teknoroman/BotKar-UPA/README.md

# BotKar-UPA
### Hezkuntza mailan erabiltzeko robota.

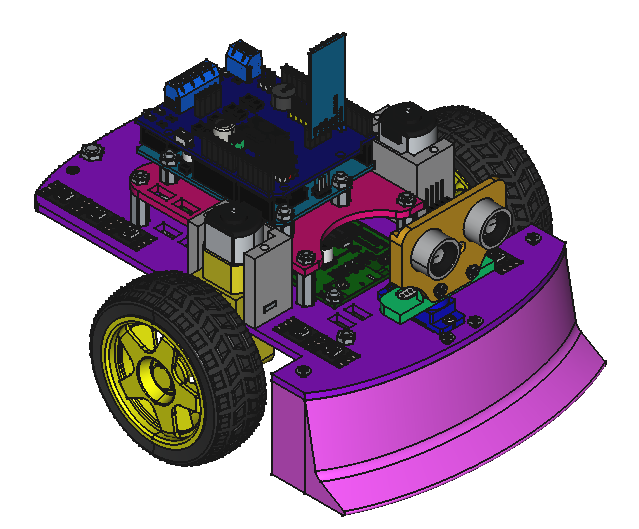
[picture p1: BotKarUPA.png]
