teknoroman/BotKar-UPA/AURKEZPENAK/6.1.- PROGRAMAZIO INGURUNEA_ HELLO BLOCKS (24-25).pptx

## PROGRAMAZIO INGURUNEA HELLO BLOCKS

KONTROLA - AUTOMATIZAZIOA - PROGRAMAZIOA

2024 - 2025 IKASTURTEA
IES USANDIZAGA-PEÑAFLORIDA-AMARA BHI

## HELLO BLOCKS

- ZER DA? UNO MIKROKONTROLAGAILUA ONLINE ETA BLOKEEN BIDEZ PROGRAMATZEKO INGURUNEA
- WEB GUNEA: https://hello-blocks.com/
- ALDE: ONLINE; BLOKEETAN PROGRAMATU; EZ DA EZER INSTALATU BEHAR; EUSKARAZ.

## HELLO BLOCKS PROGRAMATZEKO PAUSUAK

1.

2.

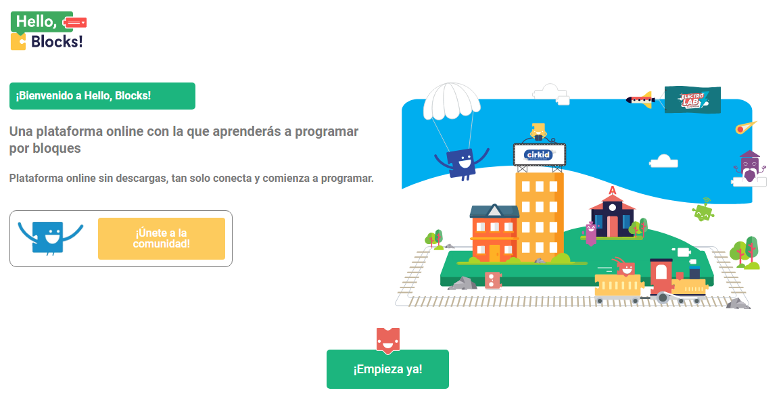
[picture p2: figure]
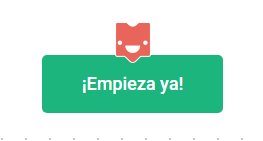
[picture p3: figure]
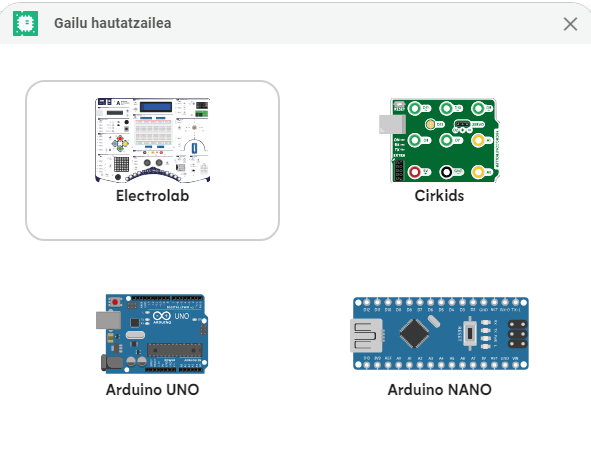
[picture p4: figure]

3.

## 2.- HELLO BLOCKS PROGRAMAZIO INGURUNEA

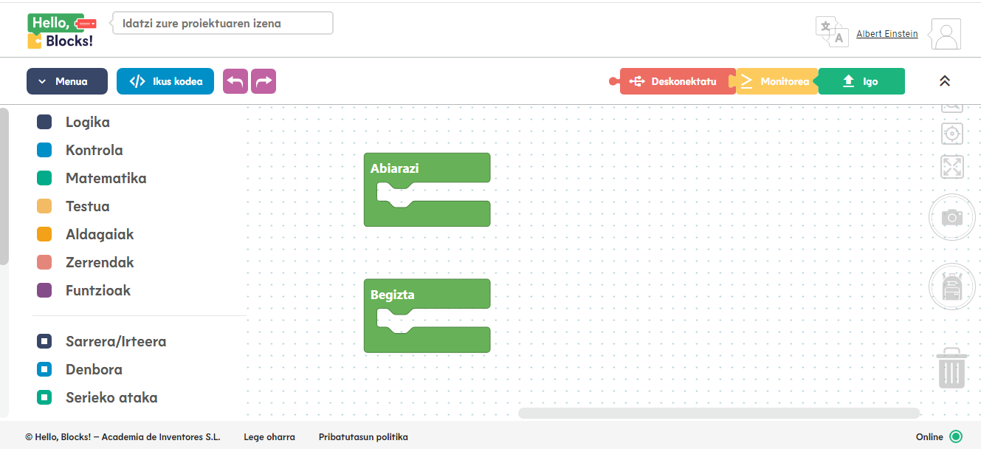
[picture p5: figure]

## Slide 5

TEKNOROMAN

IES USANDIZAGA-PEÑAFLORIDA-AMARA BHI

ARDUINO UNO PROGRAMATZEA

Fluxu diagrama (1.prog.)

Ordenagiluan programa idatzi aurretik, pinen esleipena egin behar da zeintzuk izango diren sarrerak eta zeintzuk irteerak ezarriz eta pin bakoitzean zein osagai egongo den konektatua adieraziz. Ondoren fluxu diagrama baten bitartez programaren nondik norakoa marrazten da.

INDUSTRIA TEKNOLOGIA

hasiera

aginduak

baldintzak

bai

ez

http://teknologiaroman.blogspot.com.es/

Hasiera
Aldagaien deklarazioa eta setup

LED
piztu

ITXOIN 5s.

LED
itzali

ITXOIN 5s.

“KAIXO MUNDUA” programarako adibidea

ARDUINO

## Slide 6

TEKNOROMAN

IES USANDIZAGA-PEÑAFLORIDA-AMARA BHI

ARDUINO UNO PROGRAMATZEN

pinen esleipena (1. prog.)

Ordenagiluan programa idatzi aurretik, pinen esleipena egin behar da zeintzuk izango diren sarrerak eta zeintzuk irteerak ezarriz eta pin bakoitzean zein osagai egongo den konektatua adieraziz. Ondoren fluxu diagrama baten bitartez programaren nondik norakoa marrazten da.

INDUSTRIA TEKNOLOGIA

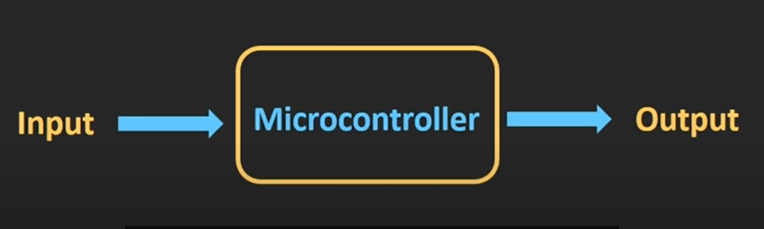
[picture p6: figure]

PINEN ESLEIPEN TAULA

SENTSORE/ERAGINGAILU | MOTA | ALDAGAIA | PINA
LED | IRTEERA DIGITALA | LED | 2

http://teknologiaroman.blogspot.com.es/

“KAIXO MUNDUA” programarako adibidea

ARDUINO
