teknoroman/BotKar-UPA/AURKEZPENAK/BotKarUPA-GANTT DIAGRAMA (2024-2025).docx

BotKarUPA (2024-2025) EPEAK - GANTT DIAGRAMA

| Mar27 | Api1 | Api3 | Api8 | Api10 | api29 | Mai6 | Mai8 | Mai13 | EKAINAK 2-5 | EKAINAK 6
MUNTAIA
PROIEKTU HASIERA - AURKEZPENA
ROBOT MUNTAIA: MATERIAL BANAKETA - IDENTIFIKAZIOA
ROBOT MUNTAIA: TXASISA+MOTORRAK+ELIKATZEA
ROBOT MUNTAIA: KONTROLA+DRIVER-a
ROBOT MUNTAIA: INFRAGORRI SENTSOREAK
ROBOT MUNTAIA: ULTRASOINU SENTSOREA + SERBOA
PROGRAMAZIOA
TESTAK: SOINUA+MOTORRA+ARGIAK
TESTAK: ULTRASOINU+INFRAGORRI
ROBOTA PROGRAMATU: ERRONKAK

LEHIAKETA
ROBOT LEHIAKETA: PRESTAKETA
ROBOT LEHIAKETA EGUNA
