teknoroman/BotKar-UPA/EBALUAZIOA/TKING-I5K KUADERNO DIGITALA (24-25) fitxategiaren kopia.docx

BotKarUPA ebaluaziorako txantiloia (24-25) 5K

Zb | IZEN ABIZENAK | BUKATUTA. | SOINUA | NEOPIXEL | MOTORRAK | DISTANTZIA | INFRAGORRIAK
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
Zb | IZEN ABIZENAK | BUKATUTA. | SOINUA | NEOPIXEL | MOTORRAK | DISTANTZIA | INFRAGORRIAK
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
TEKNOLOGIA MINTEGIA/DEPARTAMENTO DE TECNOLOGÍA
