teknoroman/BotKar-UPA/AURKEZPENAK/0.- AURKEZPENA - ROBOTIKA ETA PROGRAMAZIOA BotKar-UPA (24-25).pptx

## ROBOTIKA- PROGRAMAZIOA- KONTROLA BotKar-UPA AURKEZPENA

2024 - 2025 IKASTURTEA
IES USANDIZAGA-PEÑAFLORIDA-AMARA BHI

ZER DA ROBOTIKA https://zthiztegia.elhuyar.eus/terminoa/eu/robot ZER DA PROGRAMAZIOA https://zthiztegia.elhuyar.eus/terminoa/eu/programazio ZER DA KONTROLA https://zthiztegia.elhuyar.eus/terminoa/eu/kontrol AUTOMATIKA https://zthiztegia.elhuyar.eus/terminoa/eu/automatika AUTOMATISMOA https://zthiztegia.elhuyar.eus/terminoa/eu/automatismo

https://berezuma.com/batx2/kontrol-sistemak-motak/

## KONTROL SISTEMAREN OSAGAIAK

SISTEMA
PROZESUA

ZER KONTROLA DAITEKE ETA ZER EZ

ERANTZUNA, PORTAERA IKERTU

SARRERA ALDAGAIAK

SISTEMA
PROZESUA

IRTEERA ALDAGAIAK

PERTURBAZIOAK

## KONTROL MOTAK BEGIZTA IREKIA BEGIZTA ITXIA

SARRERA ALDAGAIAK

KONTROLAGAILUA

SISTEMA
PROZESUA

IRTEERA ALDAGAIAK

PERTURBAZIOAK

SARRERA ALDAGAIAK

KONTROLAGAILUA

SISTEMA
PROZESUA

IRTEERA ALDAGAIAK

PERTURBAZIOAK

BERRELIKADURA

## BotKarUPA

mClon

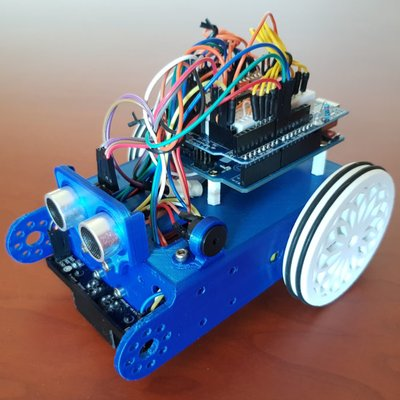
[picture p7: figure]

https://tecnoloxia.org/mclon/


mClon-UPA

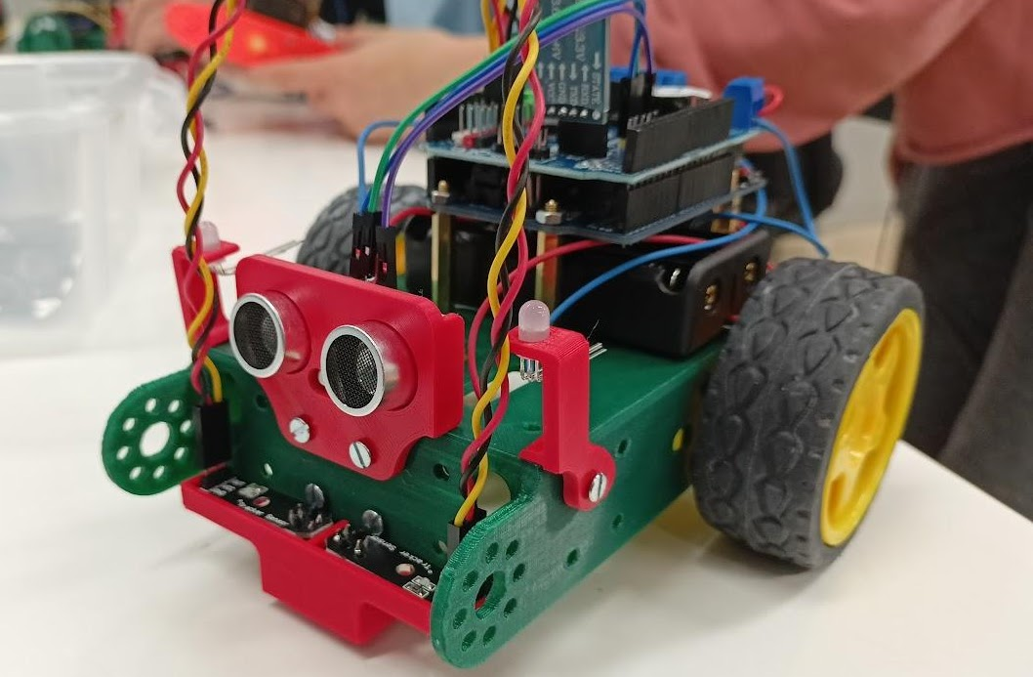
[picture p8: figure]

https://sites.google.com/upainstitutua.org/mclon-upa/sarrera

## HELBURUA

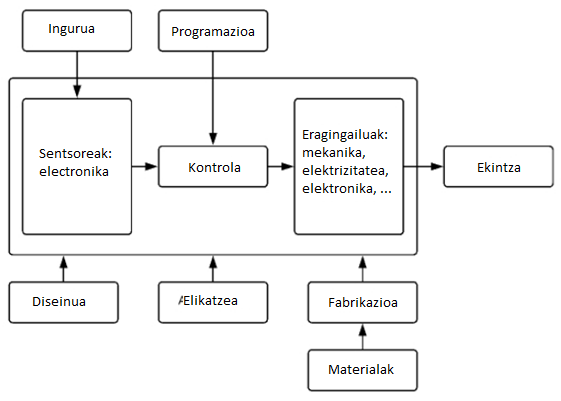
[picture p9: figure]

María Loureiro
@tecnoloxia (https://twitter.com/tecnoloxia?lang=en)

## MUNTAIA + TESTAK + LEHIAKETA

0.- MATERIALAREN IDENTIFIKAZIOA
1.- TXASISA ETA MOTORRAK
2.- ELIKATZE SISTEMA
3.- KONTROL PLACA: ARDUINO + FUNDUMOTO SHIELD
4.- SENTSOREAK: ULTRASOINUAK ETA INFRAGORRIAK

5.- ARGIAK: NEOPIXEL
6.- KOMUNIKAZIOA: BLUETOOTH

## ERRONKAK - LEHIAKETA

1.- PUNTU KARDINALAK
2.- ESKORTATIK IRTEN
3.- LERRO JARRAITZAILEA
4.- SUMO
4’.- SUMO
5.- LASTERKETA
6.- PUXIKA BORROKA

AUTONOMOA

GIDATUA

## ARGITARATZEA

1.- MUNTAIA-TESTAK-FROGAK
2.- BEHIN-BETIKO EMAITZAK
3.- IRUDIAK
4.- BIDEOAK
5.- KODEA
6.- AZALPENAK

SITES

HELBURUA

ERREPIKAKORRA

## DENBORALIZAZIOA-EPEAK-DATAK

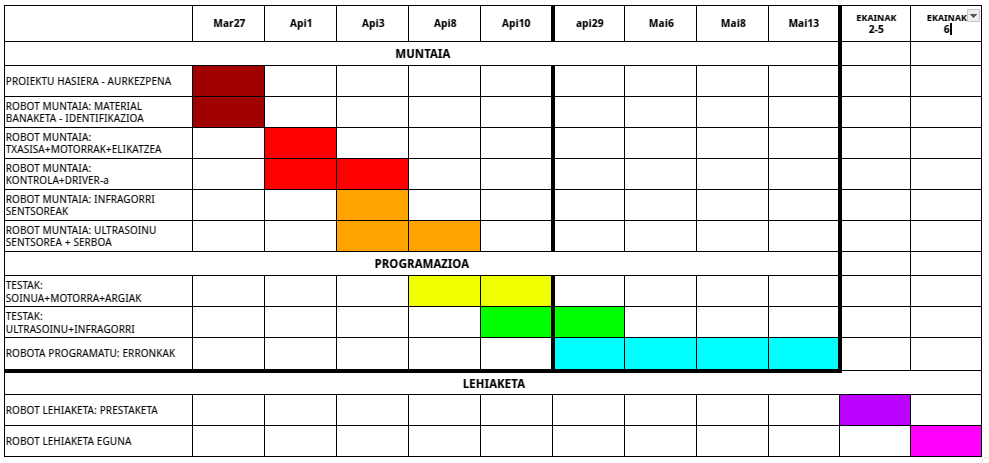
[picture p10: figure]
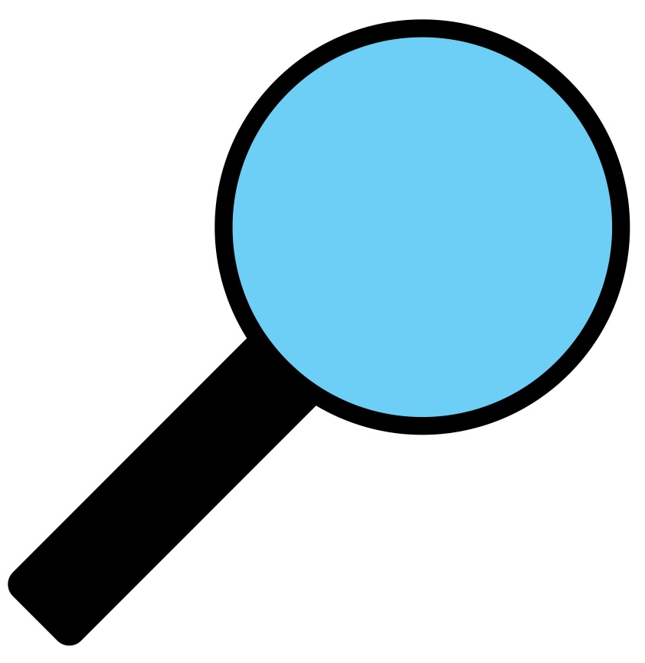
[picture p11: figure]
