teknoroman/BotKar-UPA/argazkiak-bideoak/Bideoak/IMG_20250317_153037.jpg

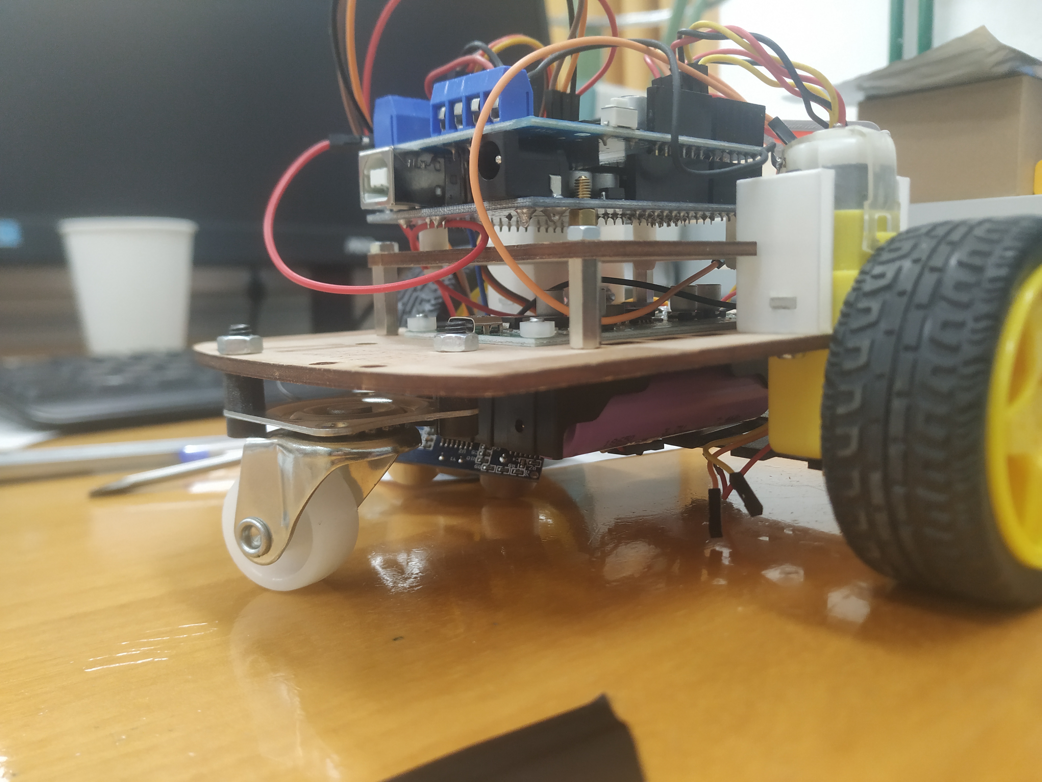
argazkiak-bideoak/Bideoak/IMG_20250317_153037.jpg
