teknoroman/BotKar-UPA/argazkiak-bideoak/Bideoak/IMG_20250404_192219.jpg

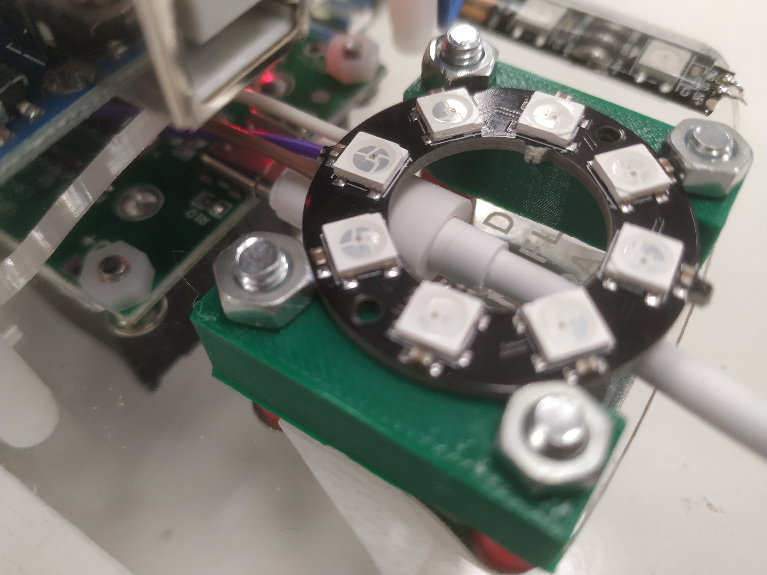
argazkiak-bideoak/Bideoak/IMG_20250404_192219.jpg
