teknoroman/BotKar-UPA/argazkiak-bideoak/Bideoak/IMG_20250404_192254.jpg

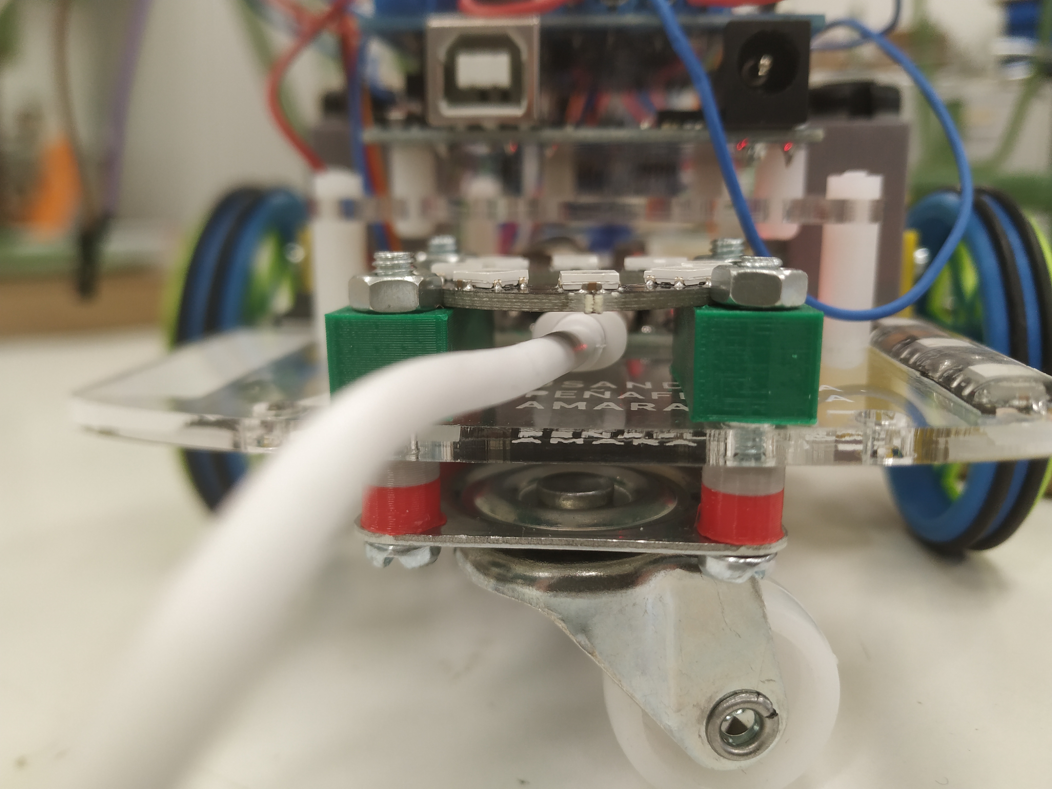
argazkiak-bideoak/Bideoak/IMG_20250404_192254.jpg
