teknoroman/BotKar-UPA/argazkiak-bideoak/Bideoak/IMG_20250407_084235.jpg

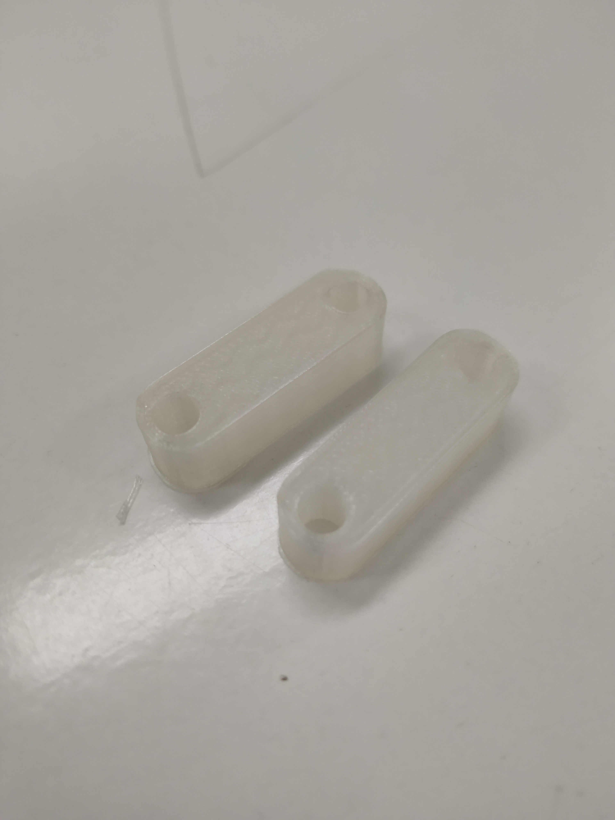
argazkiak-bideoak/Bideoak/IMG_20250407_084235.jpg
