teknoroman/BotKar-UPA/argazkiak-bideoak/Bideoak/IMG_20250407_084258.jpg

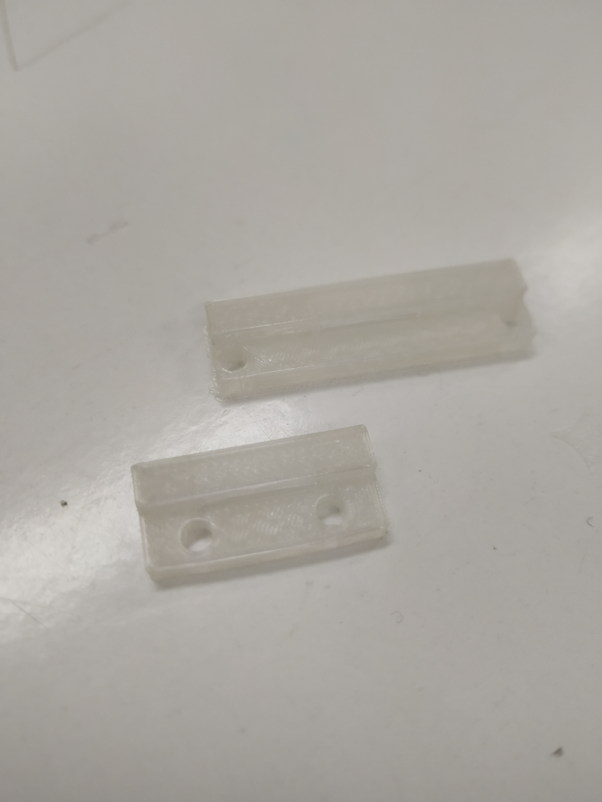
argazkiak-bideoak/Bideoak/IMG_20250407_084258.jpg
