teknoroman/BotKar-UPA/argazkiak-bideoak/Bideoak/IMG_20250407_095248.jpg

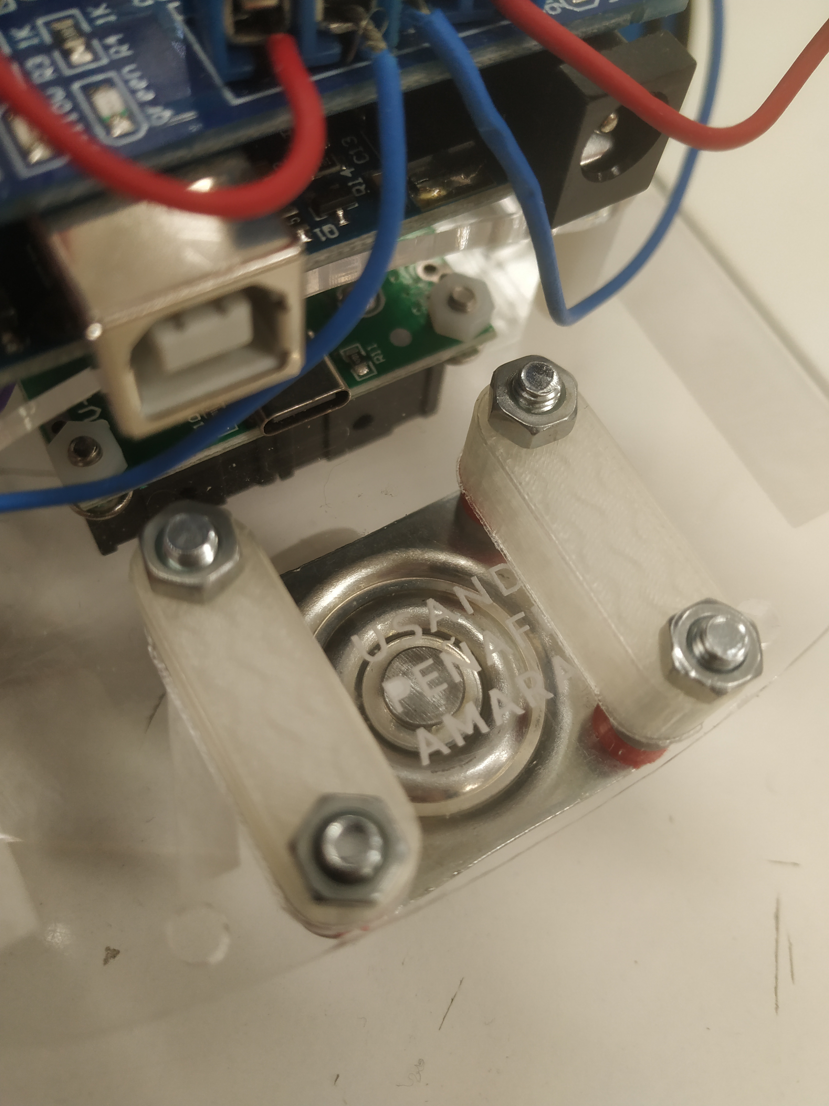
argazkiak-bideoak/Bideoak/IMG_20250407_095248.jpg
