teknoroman/BotKar-UPA/argazkiak-bideoak/Bideoak/IMG_20250407_095250.jpg

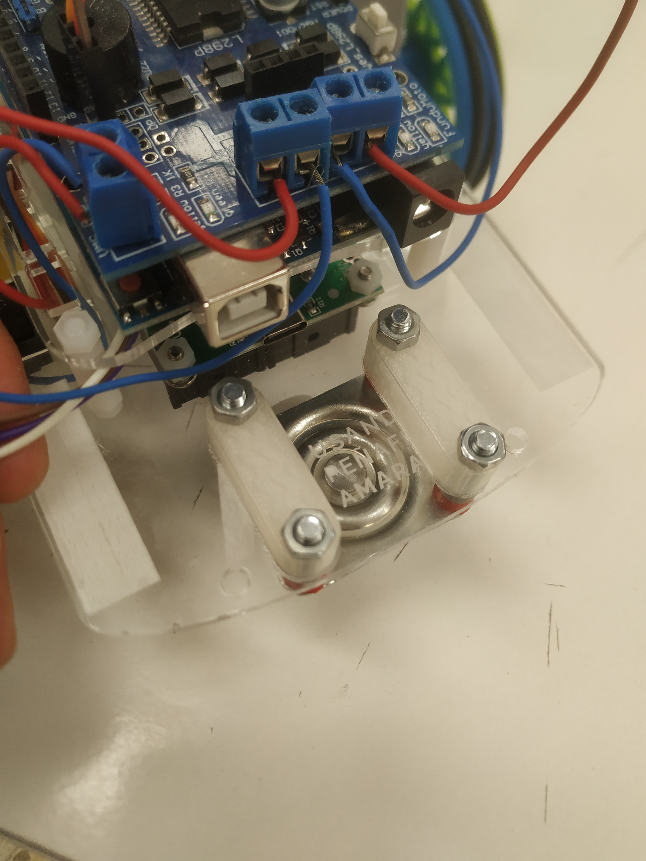
argazkiak-bideoak/Bideoak/IMG_20250407_095250.jpg
