teknoroman/BotKar-UPA/argazkiak-bideoak/Bideoak/IMG_20250407_095345.jpg

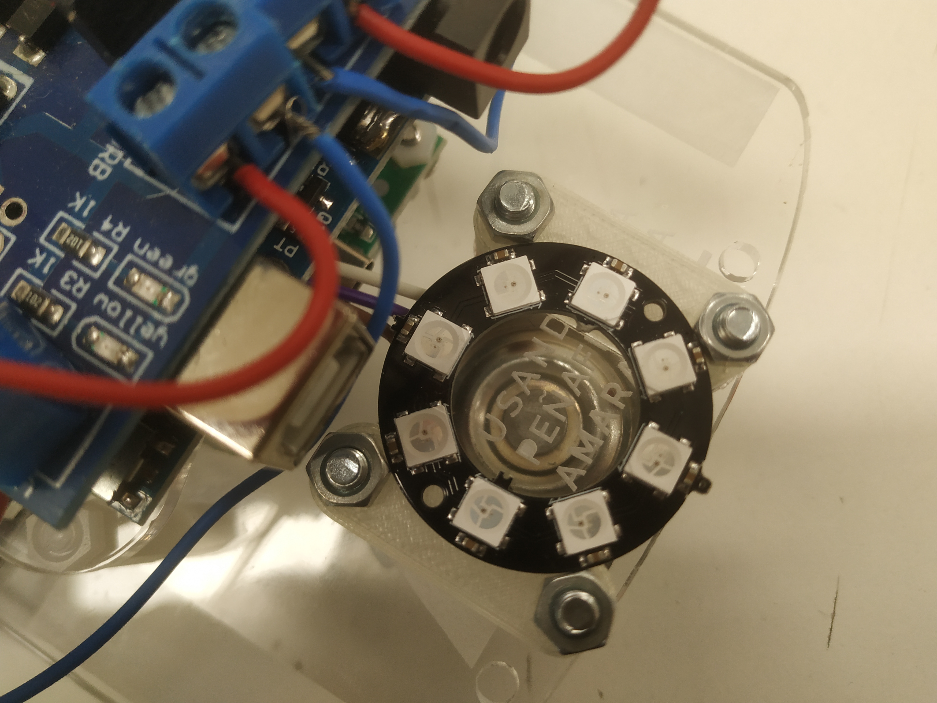
argazkiak-bideoak/Bideoak/IMG_20250407_095345.jpg
