teknoroman/BotKar-UPA/argazkiak-bideoak/Bideoak/IMG_20250407_100635.jpg

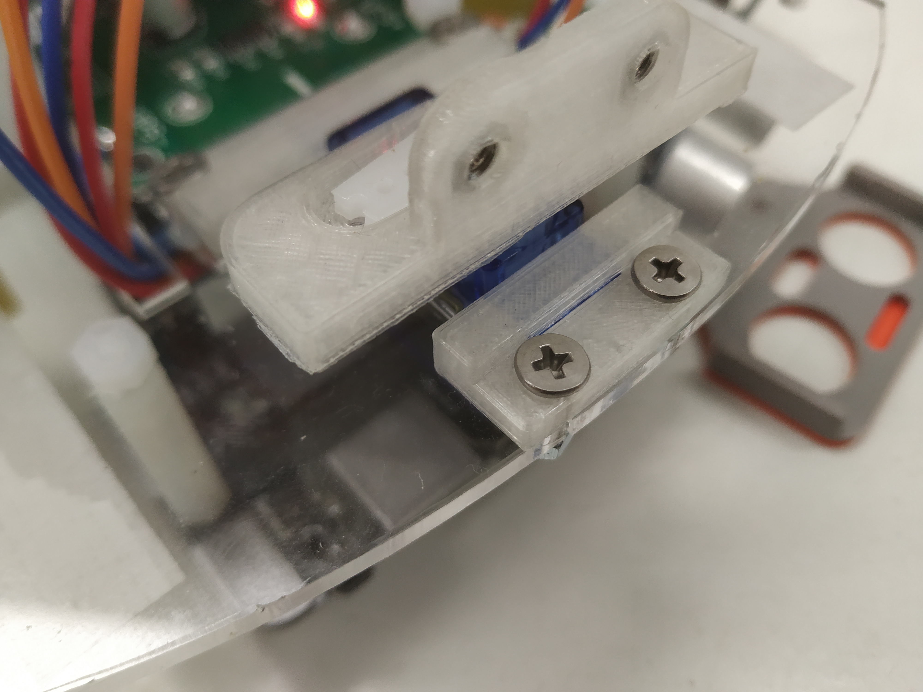
argazkiak-bideoak/Bideoak/IMG_20250407_100635.jpg
