teknoroman/BotKar-UPA/argazkiak-bideoak/Bideoak/IMG_20250407_100657.jpg

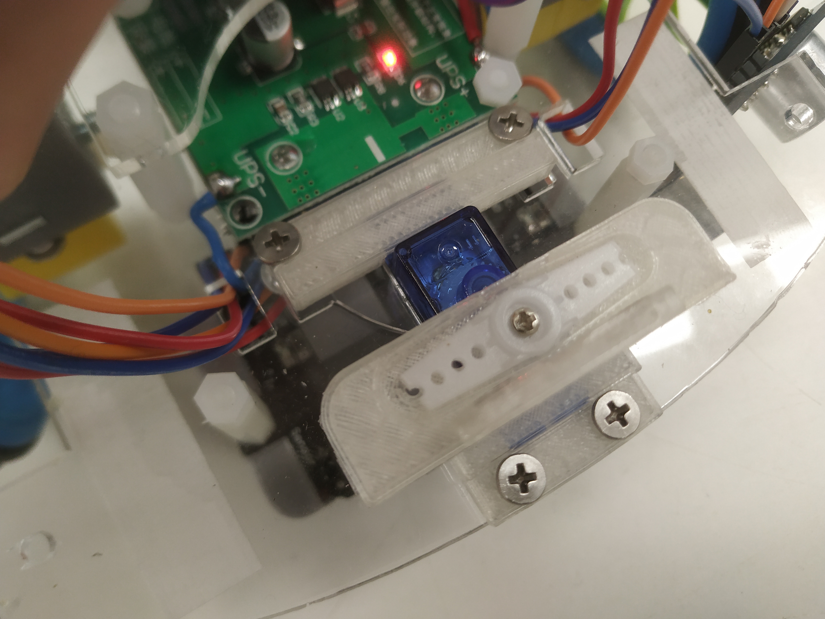
argazkiak-bideoak/Bideoak/IMG_20250407_100657.jpg
