teknoroman/BotKar-UPA/argazkiak-bideoak/Bideoak/IMG_20250407_102820.jpg

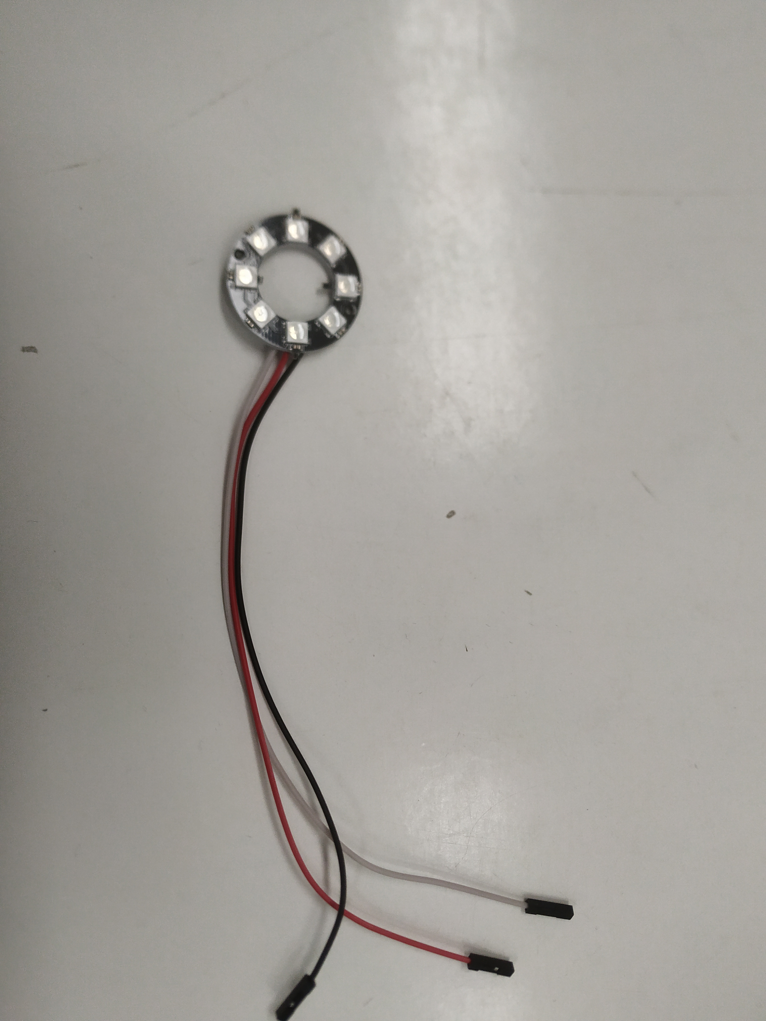
argazkiak-bideoak/Bideoak/IMG_20250407_102820.jpg
