teknoroman/BotKar-UPA/argazkiak-bideoak/Bideoak/IMG_20250407_102908.jpg

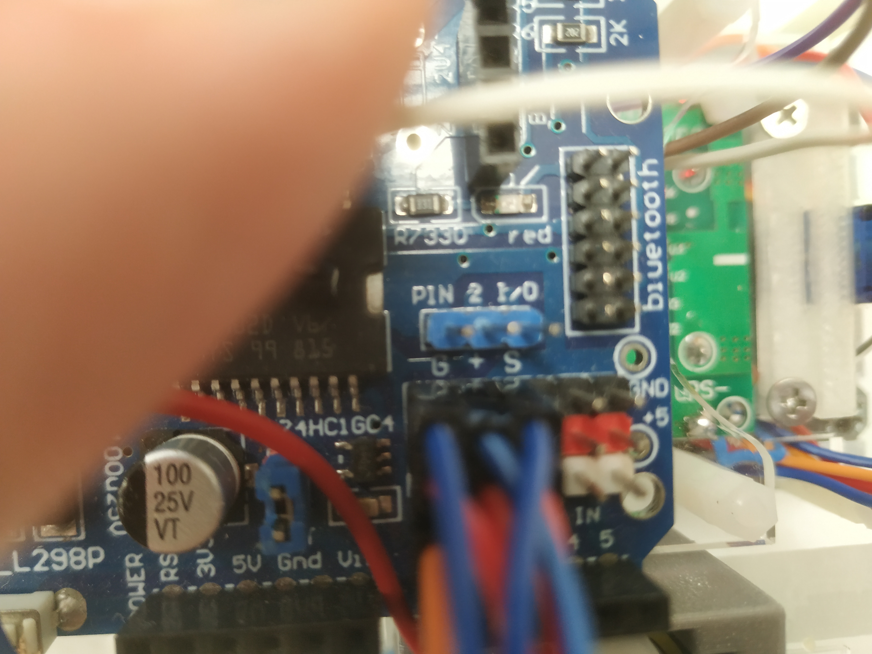
argazkiak-bideoak/Bideoak/IMG_20250407_102908.jpg
