teknoroman/BotKar-UPA/argazkiak-bideoak/Bideoak/IMG_20250428_235727.jpg

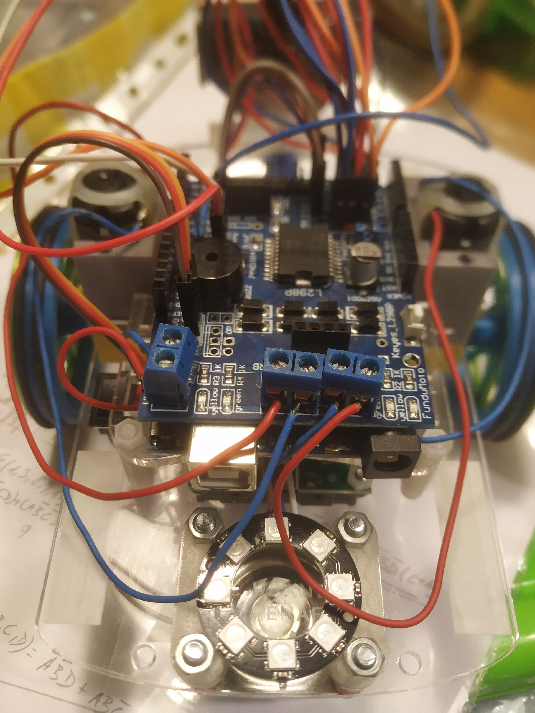
argazkiak-bideoak/Bideoak/IMG_20250428_235727.jpg
