teknoroman/BotKar-UPA/argazkiak-bideoak/Bideoak/IMG_20250428_235746.jpg

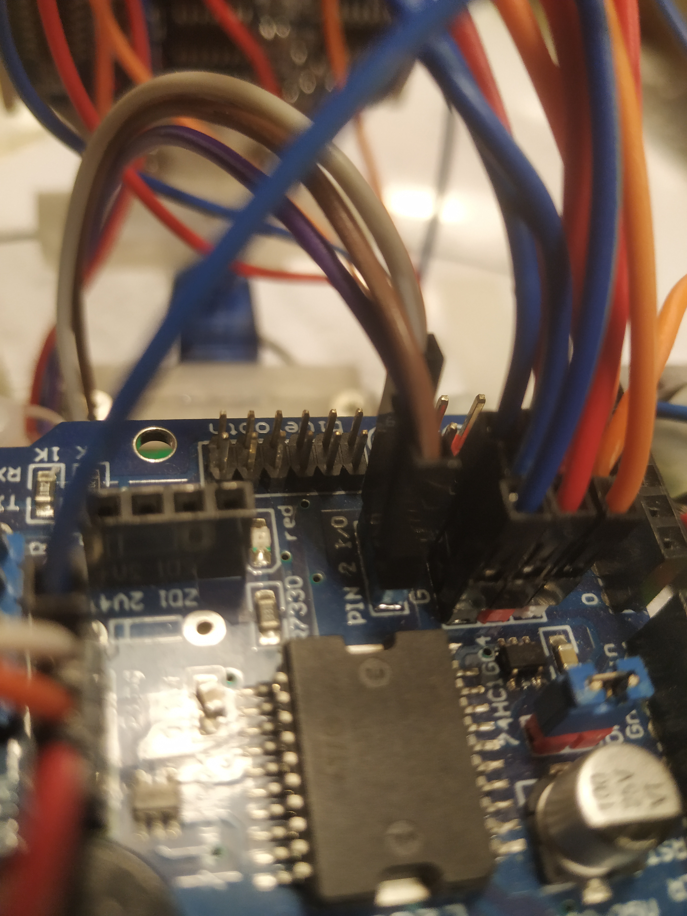
argazkiak-bideoak/Bideoak/IMG_20250428_235746.jpg
