teknoroman/BotKar-UPA/EBALUAZIOA/DISTANTZIA ETA INFRAGORRIAK.png

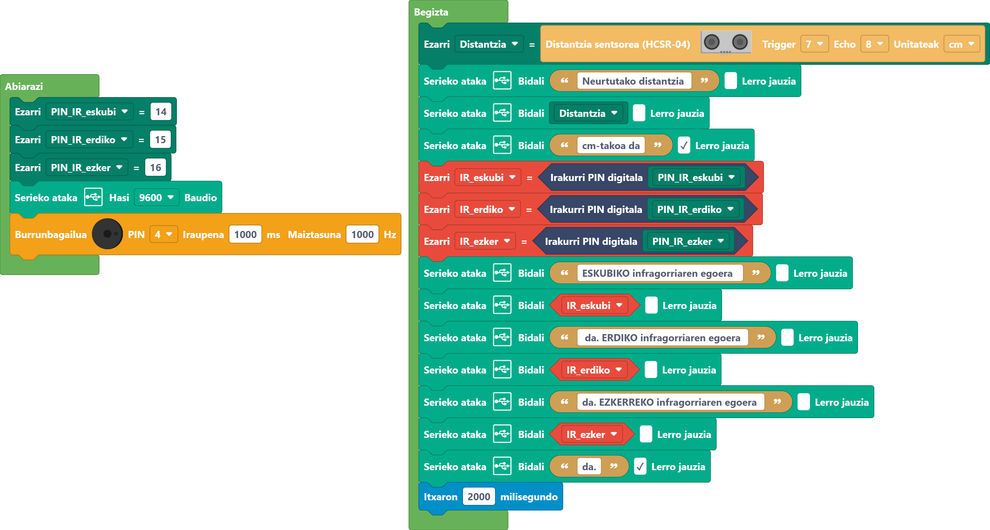
EBALUAZIOA/DISTANTZIA ETA INFRAGORRIAK.png
