teknoroman/BotKar-UPA/EBALUAZIOA/SOINUA-ARGIAK-MOTORRAK.png

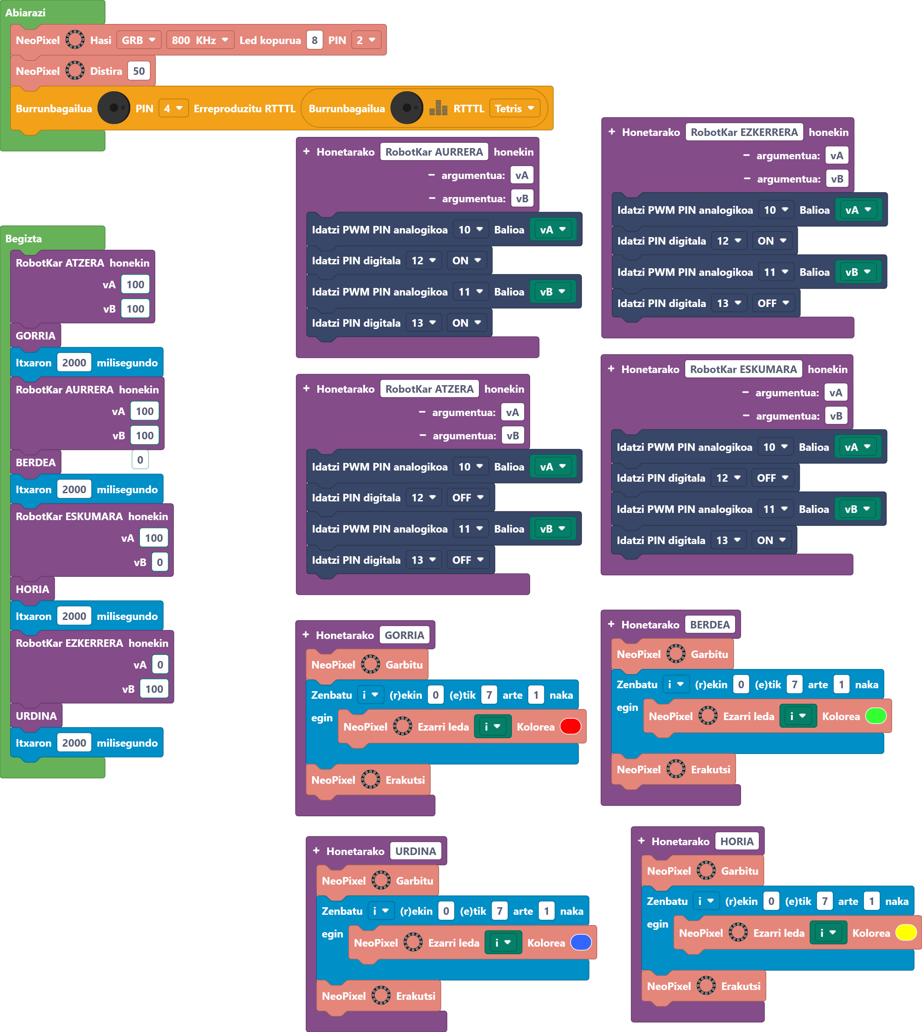
EBALUAZIOA/SOINUA-ARGIAK-MOTORRAK.png
