teknoroman/BotKar-UPA/PROGRAMAK/ARGI FROGAK.png

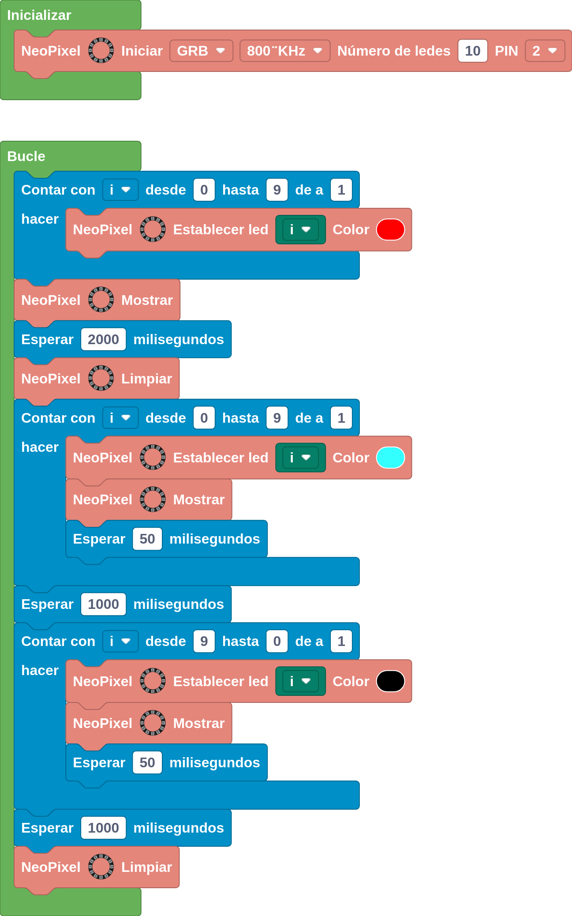
PROGRAMAK/ARGI FROGAK.png
