teknoroman/BotKar-UPA/PROGRAMAK/BLUETOOTH (KarBotUPA).png fitxategiaren kopia.png

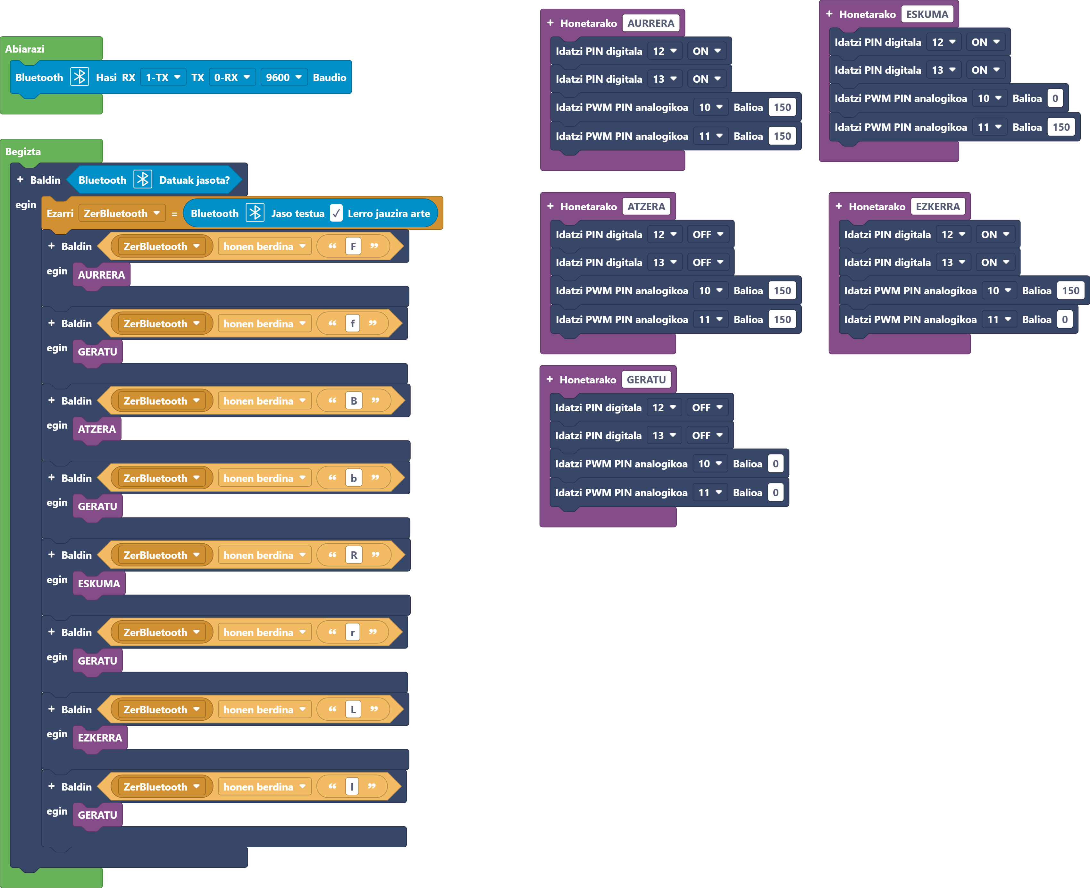
PROGRAMAK/BLUETOOTH (KarBotUPA).png fitxategiaren kopia.png
