teknoroman/BotKar-UPA/PROGRAMAK/BuruaBiratuz.png

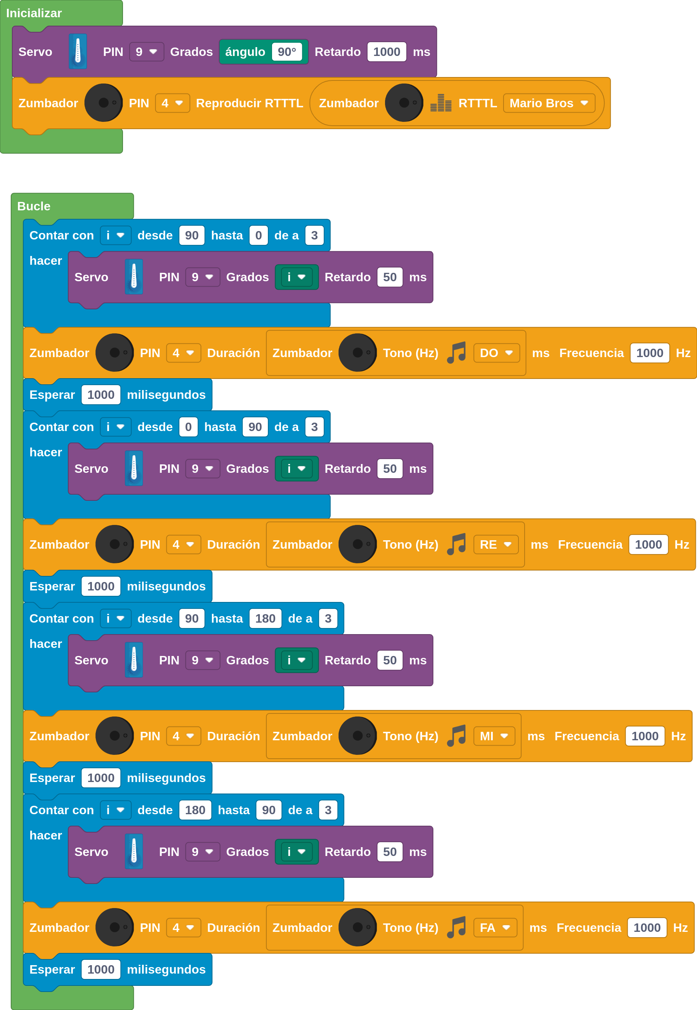
PROGRAMAK/BuruaBiratuz.png
