teknoroman/BotKar-UPA/PROGRAMAK/FROGA-BLUETOOTH-APPINVENTOR (1).png

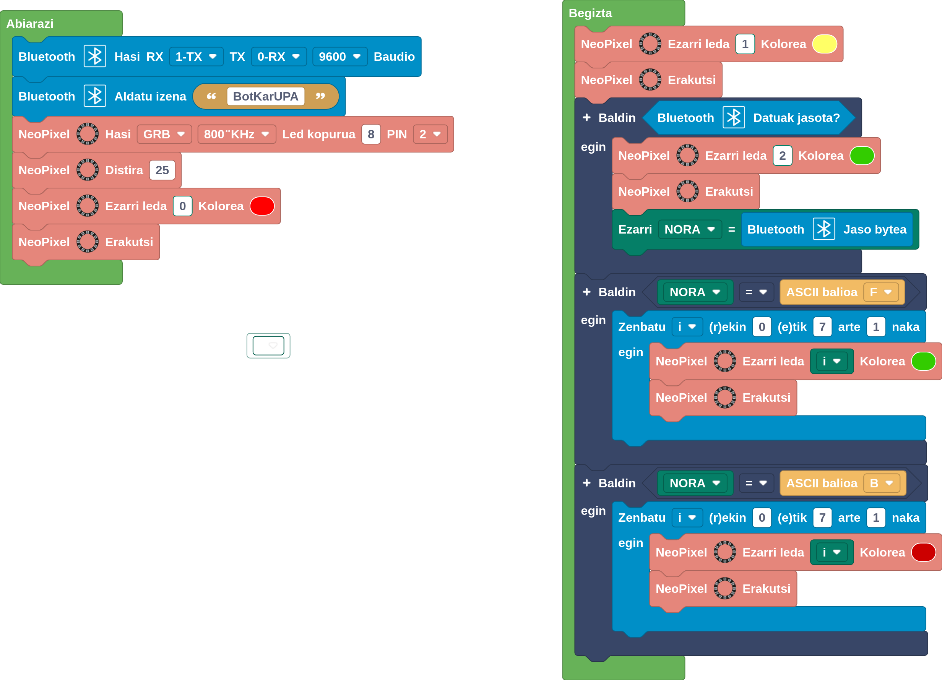
PROGRAMAK/FROGA-BLUETOOTH-APPINVENTOR (1).png
