teknoroman/BotKar-UPA/PROGRAMAK/MOTORRAK AURRERA ETA ATZERA.png

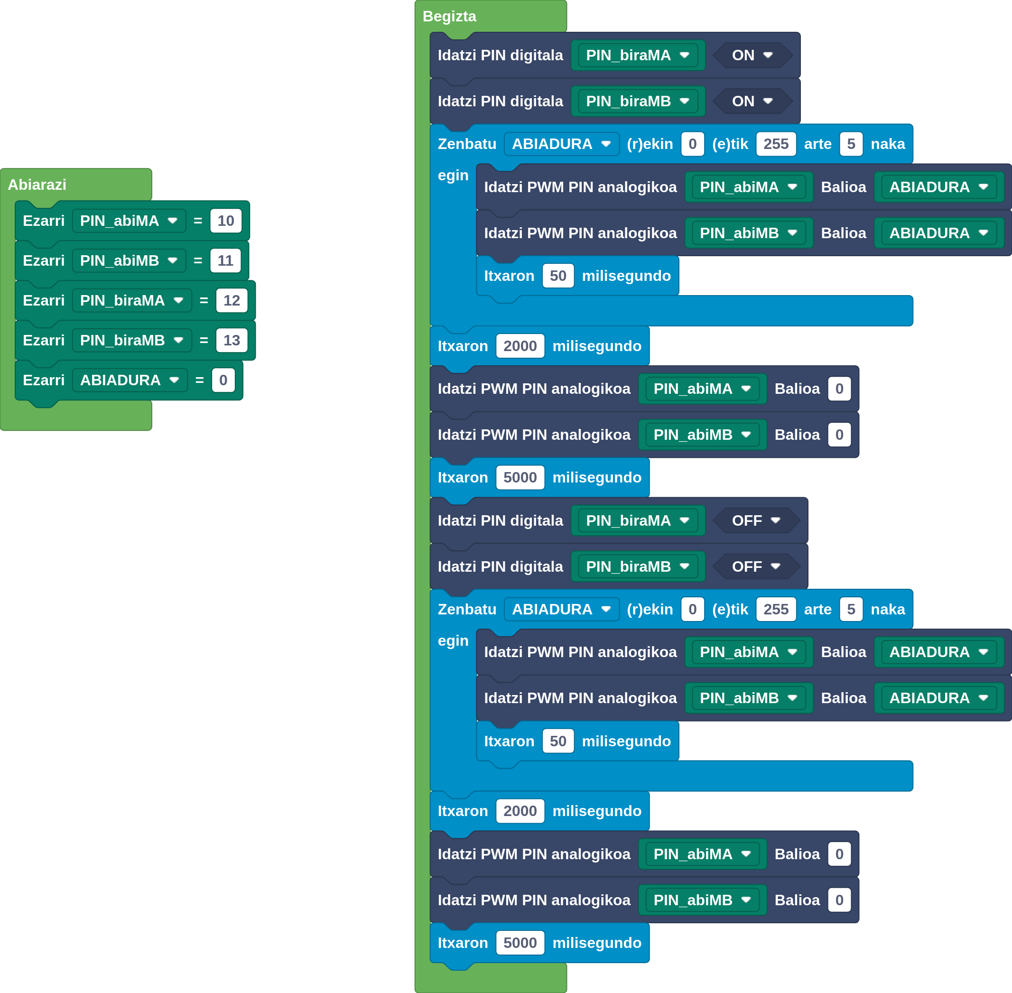
PROGRAMAK/MOTORRAK AURRERA ETA ATZERA.png
