teknoroman/BotKar-UPA/PROGRAMAK/motorrak-frogatzen 2.png

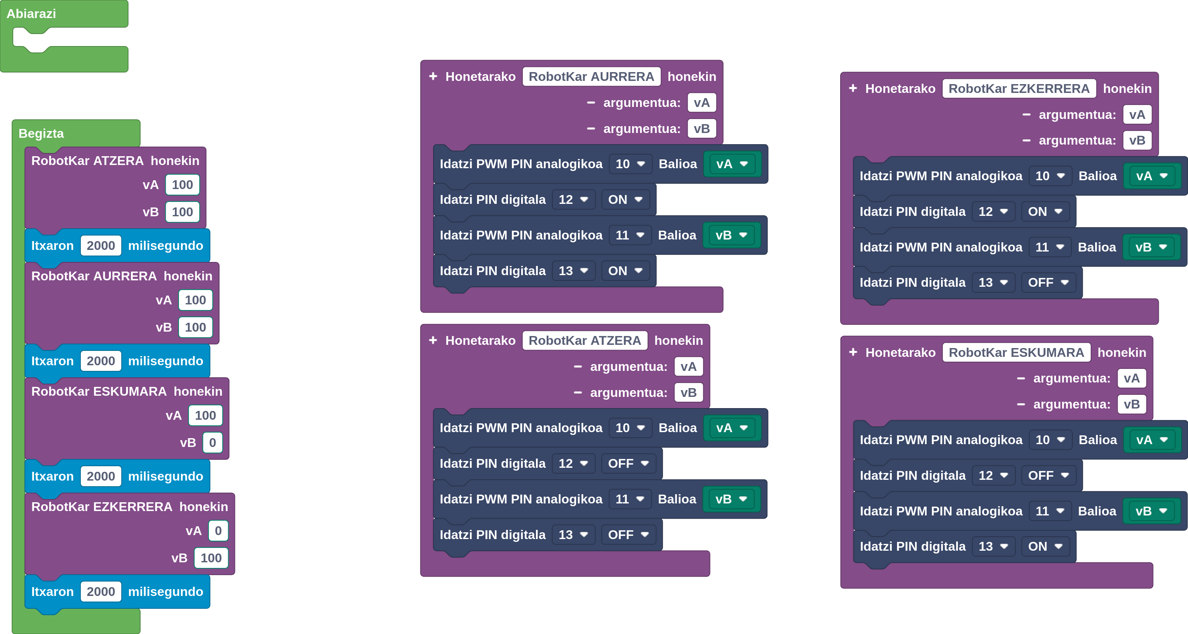
PROGRAMAK/motorrak-frogatzen 2.png
