teknoroman/BotKar-UPA/PROGRAMAK/motorrak-frogatzen.png

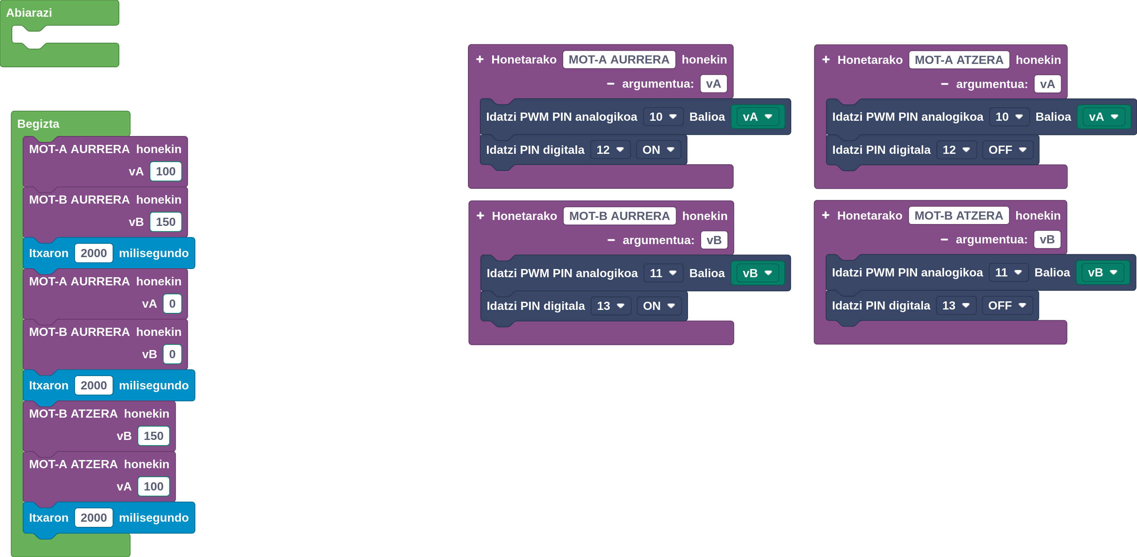
PROGRAMAK/motorrak-frogatzen.png
