teknoroman/BotKar-UPA/PROGRAMAK/Soinu Froga.png

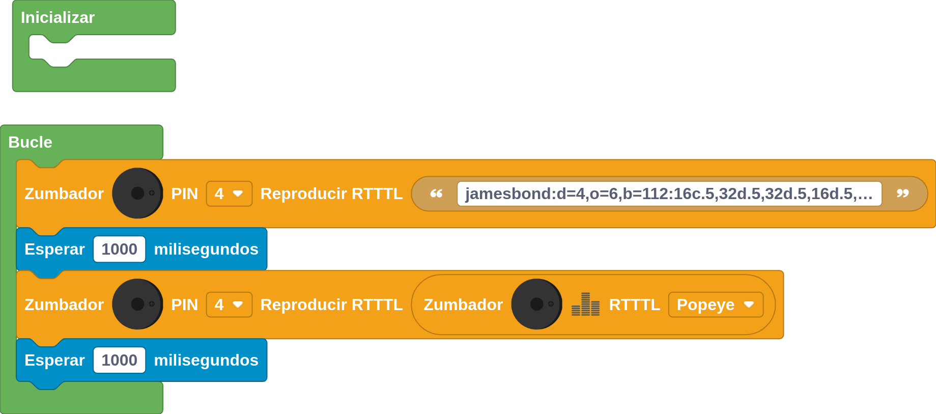
PROGRAMAK/Soinu Froga.png
