teknoroman/BotKar-UPA/PROGRAMAK/ULTRASOINU ETA MOTORRAK.png

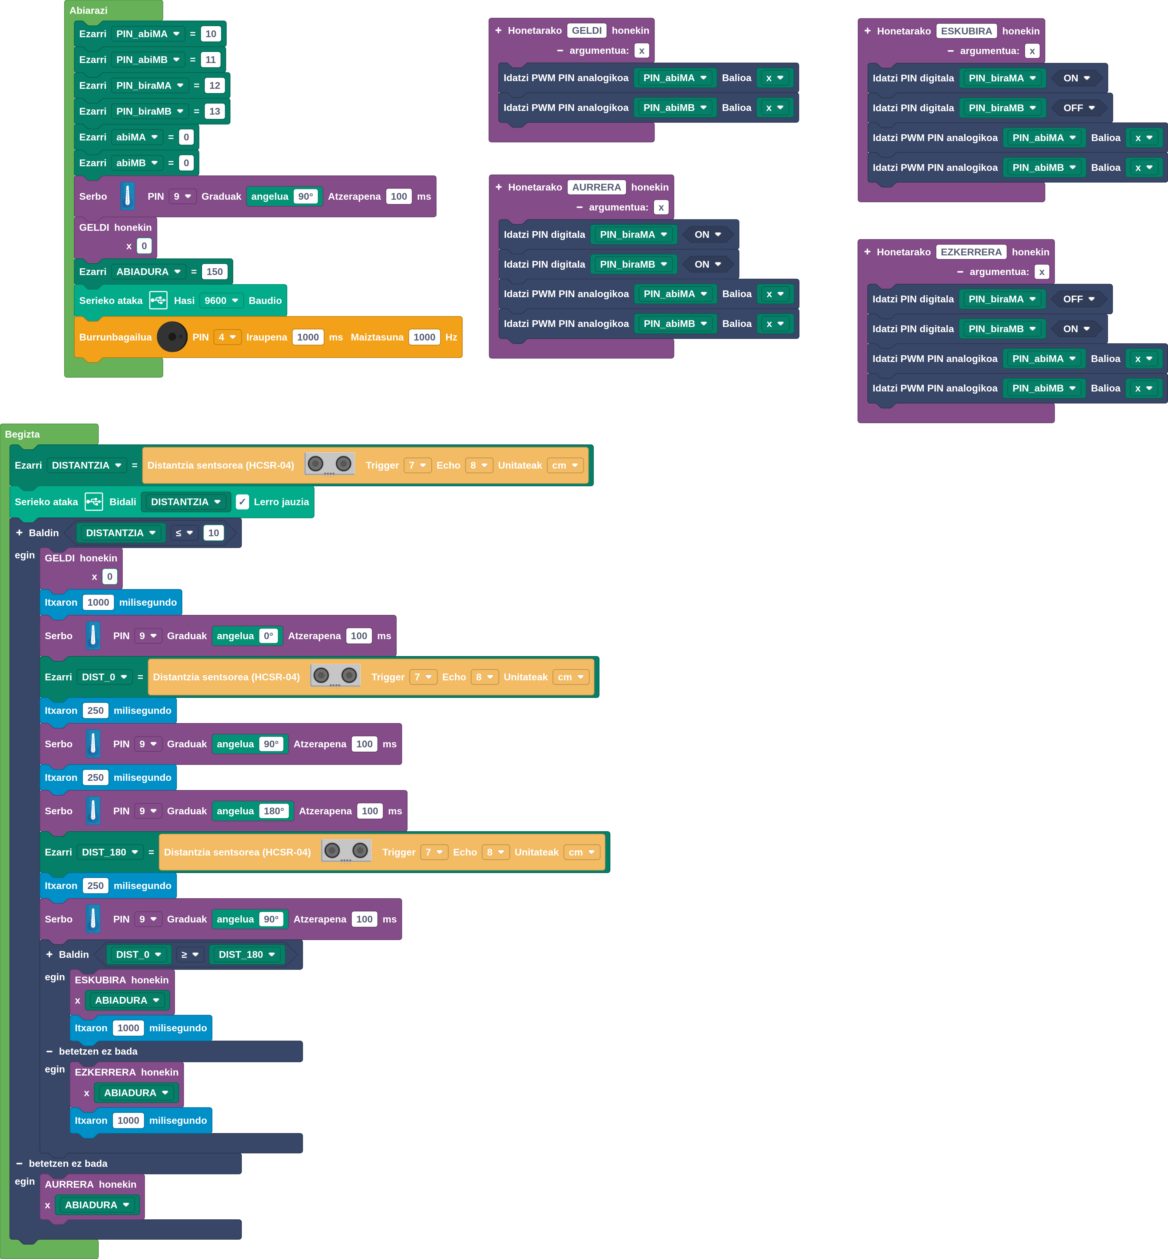
PROGRAMAK/ULTRASOINU ETA MOTORRAK.png
