teknoroman/BotKar-UPA/AURKEZPENAK/1.- MATERIAL BANAKETA - ROBOTIKA ETA KONTROLA BotKar-UPA (24-25).pptx

## MATERIAL BANAKETA

ROBOTIKA- PROGRAMAZIOA- KONTROLA
BotKar-UPA

2024 - 2025 IKASTURTE BUKAERAKO PROIEKTUA
IES USANDIZAGA-PEÑAFLORIDA-AMARA BHI

## URRATSAK

1.- KUTXEN BANAKETA ETA IDENTIFIKAZIOA
2.-KUTXAK IREKI ETA EDUKIA AZTERTU
3.- BANATUTAKO MATERIALAREN ZERRENDA EGIN
4.- KUADERNO DIGITALEAN MENDEKO ORRIAK SORTU:
- MATERIAL ZERRENDA
- MUNTAIA
- TESTAK
- ERRONKAK

## KUTXAK

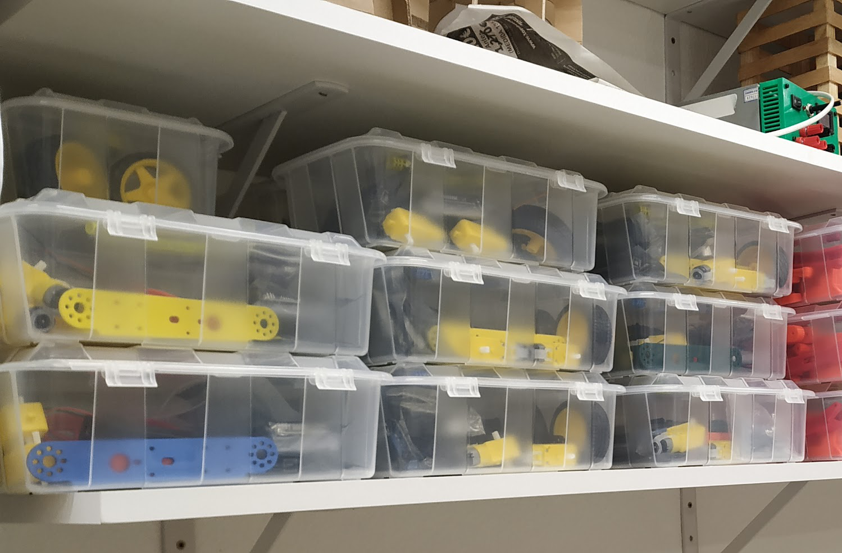
[picture p43: figure]
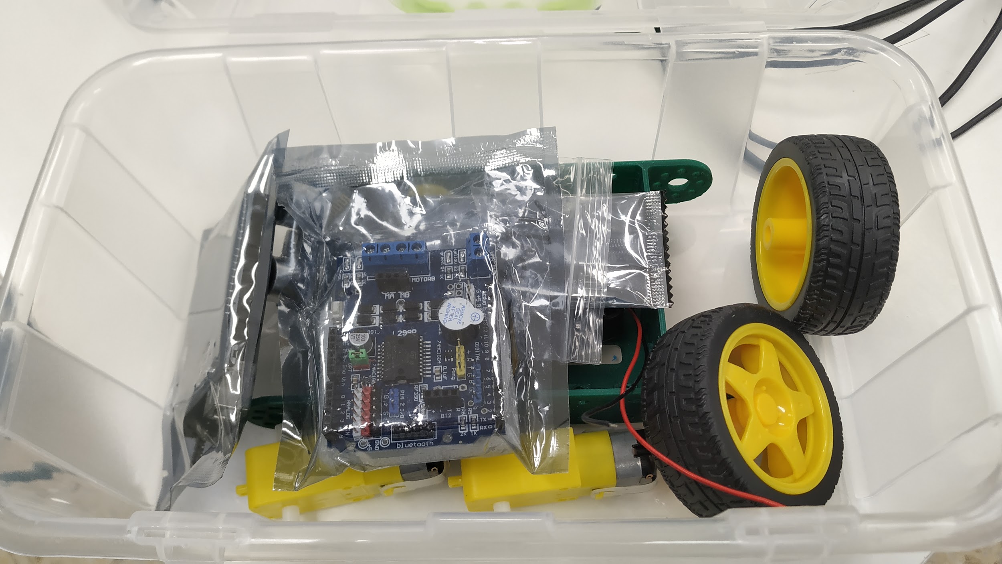
[picture p44: figure]
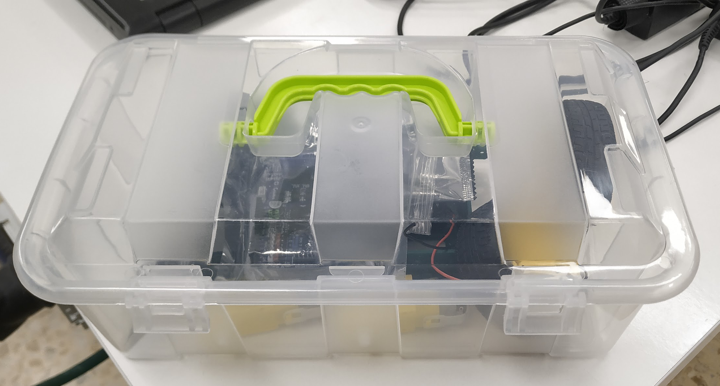
[picture p45: figure]

## KUTXAREN EDUKIA

## MATERIAL ZERRENDA

KUTXAN DAGOEN MATERIALA TXEKEATU, DAGOENA MARKATU, FALTA DENA ESKATU:

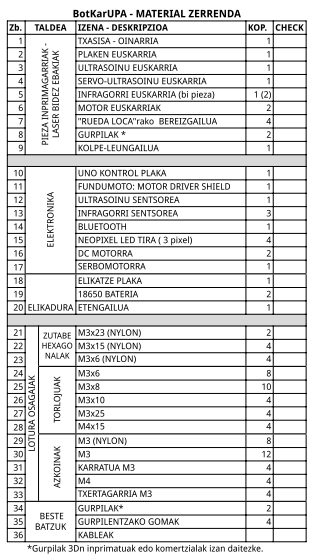
[picture p46: figure]

Material Zerrenda Kalkulu orria (https://docs.google.com/spreadsheets/d/e/2PACX-1vTUGvKVmSeLqu1SWAIDuPW1bFao5hV7_SmWLGT76KhLIY3JkJ1LBumH0BhA_g7SCpxtpCpAwPCh9a0d/pubhtml)

## Slide 6
