teknoroman/BotKar-UPA/MATERIAL ZERRENDA/BotKar-UPA - LISTADO MATERIAL.xlsx

BotKarUPA - LISTADO MATERIAL (24-25)
Nº | GRUPO |  | NOMBRE - DESCRIPCIÓN | CANT. | CHECK
1 | PIEZAS IMPRIMIBLES - CORTADAS CON LÁSER |  | CHASIS - BASE | 1
2 |  |  | SOPORTE PLACAS | 1
3 |  |  | SOPORTE ULTRASONIDOS | 1
4 |  |  | SOPORTE SERVO-ULTRASONIDOS | 1
5 |  |  | SOPORTE SERVO | 2
6 |  |  | SOPORTE INFRARROJOS (dos piezas) | 1 (2)
7 |  |  | SOPORTE MOTOR | 2
8 |  |  | DISTANCIADOR "RUEDA LOCA" | 4
9 |  |  | RUEDAS * | 2
10 |  |  | SOPORTE ANILLO NEOPIXEL | 2
11 |  |  | PARACHOQUES | 1
12 | ELECTRONICA |  | PLACA CONTROL ARDUINO UNO | 1
13 |  |  | FUNDUMOTO: MOTOR DRIVER SHIELD | 1
14 |  |  | SENSOR ULTRASONIDOS | 1
15 |  |  | SENSOR INFRARROJOS | 3
16 |  |  | BLUETOOTH | 1
17 |  |  | TIRAS NEOPIXEL LED ( 2x2 + 2x3 pixel) | 4
18 |  |  | MOTOR DC | 2
19 |  |  | SERVOMOTOR | 1
20 | ALIMENTACIÓN |  | PLACA ALIMENTACIÓN | 1
21 |  |  | BATERÍA 18650 | 2
22 |  |  | INTERRUPTOR | 1
23 | COMPONENTES DE UNIÓN | COLUMNAS HEXAGONALES | M3x23 (NYLON) | 2
24 |  |  | M3x15 (NYLON) | 4
25 |  |  | M3x6 (NYLON) | 4
26 |  | TORNILLOS | M3x6 (NYLON) | 10
27 |  |  | M3x8 (NYLON) | 10
28 |  |  | M3x10 | 4
29 |  |  | M3x25 | 4
30 |  |  | M4x15 | 4
31 |  | TUERCAS | M3 (NYLON) | 11
32 |  |  | M3 | 12
33 |  |  | KARRATUA M3 | 4
34 |  |  | M4 | 4
35 |  |  | TXERTAGARRIA M3 | 4
36 | OTROS |  | RUEDAS* | 2
37 |  |  | GOMAS RUEDAS | 4
38 |  |  | RUEDA LOCA | 1
39 |  |  | CABLES
 | *Las ruedas pueden ser impresas en 3D o comerciales
