teknoroman/BotKar-UPA/MUNTAIA(api7)/MUNTAIRAKO PIEZAK/sensor IR.FCStd

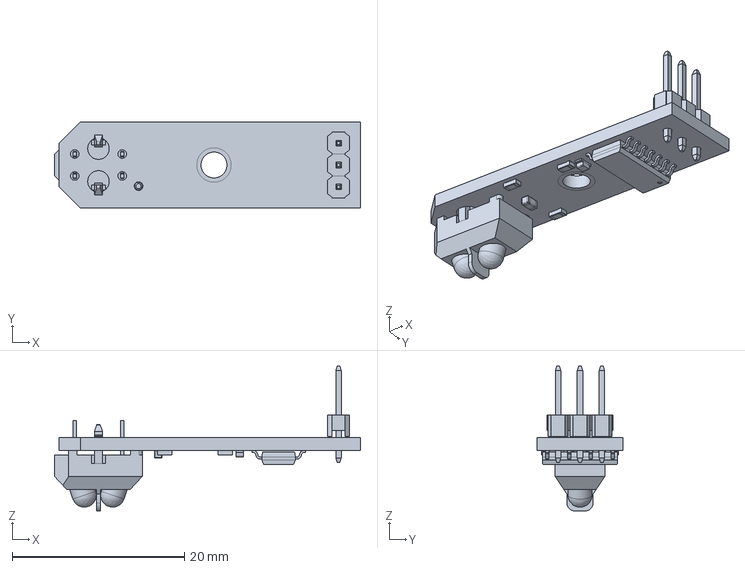
[picture p47: CAD file, 2025-07-08]
MUNTAIA(api7)/MUNTAIRAKO PIEZAK/sensor IR.FCStd
35.5 x 10.0 x 16.8 mm
