teknoroman/BotKar-UPA/MUNTAIA(api7)/serboEuskarriak.FCStd

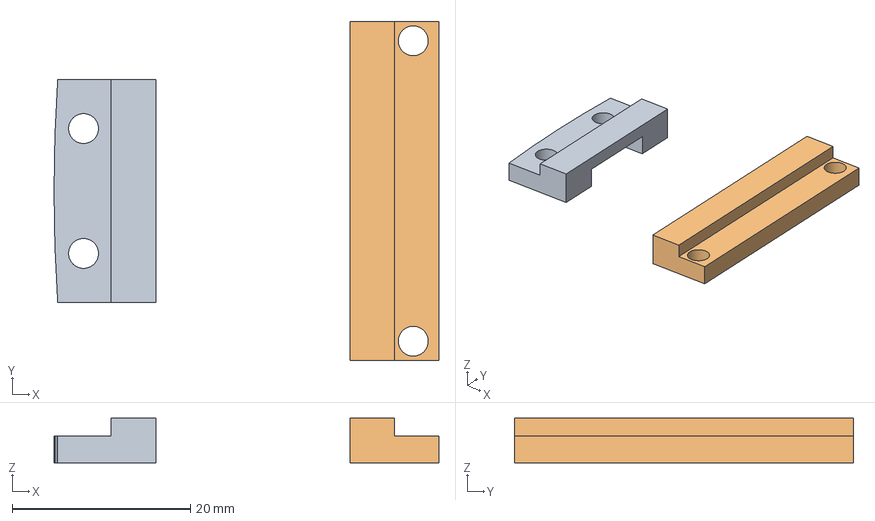
[picture p49: CAD file, 2025-07-08]
MUNTAIA(api7)/serboEuskarriak.FCStd
43.2 x 38.0 x 5.00 mm
Aurrekoa
Atzekoa
