teknoroman/BotKar-UPA/MUNTAIRAKO PIEZAK/Etengailua.FCStd

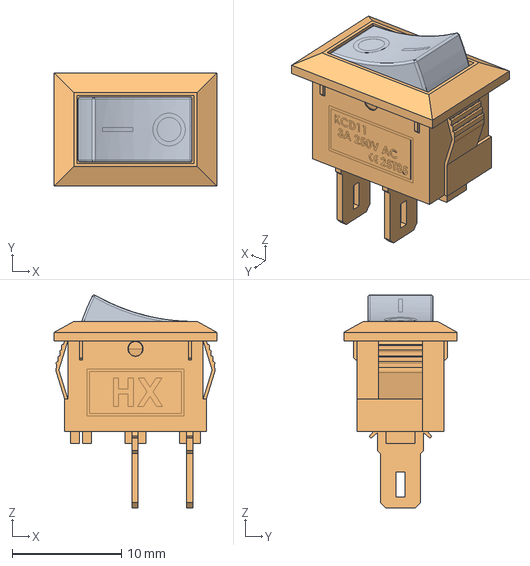
[picture p50: CAD file, 2025-07-08]
MUNTAIRAKO PIEZAK/Etengailua.FCStd
14.9 x 10.4 x 19.5 mm
Switch_mini
Switch_mini001
