teknoroman/BotKar-UPA/MUNTAIRAKO PIEZAK/STEP/CasterWheel.stp

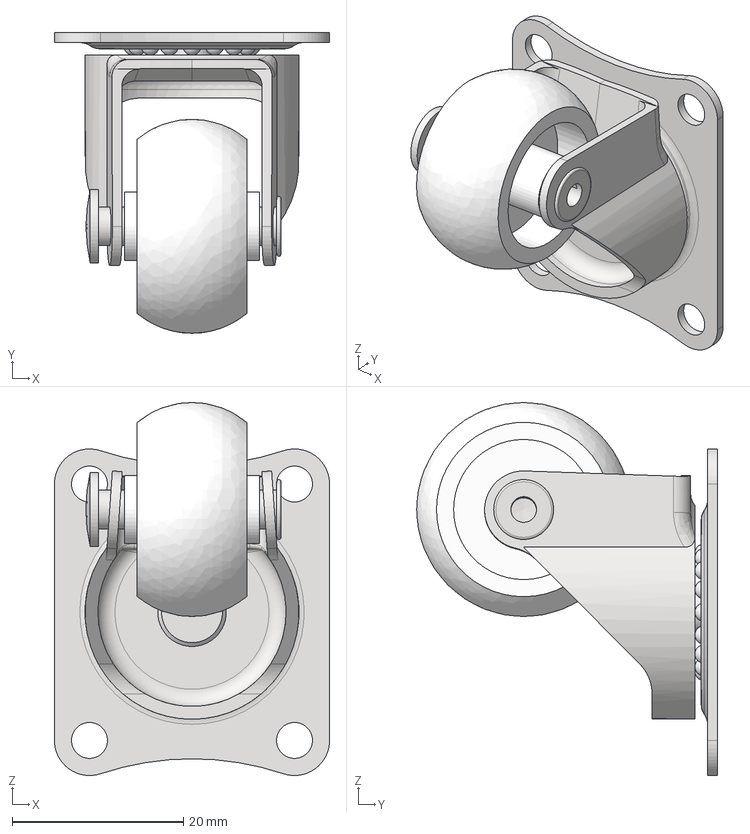
[picture p51: CAD file, 2025-07-08]
MUNTAIRAKO PIEZAK/STEP/CasterWheel.stp
32.2 x 35.1 x 43.6 mm
CasterWheel1
WheelAxle
MainCasterBody
UpperCasterBody
Bearings
CasterShaft
