teknoroman/BotKar-UPA/TXASIS ETA EUSKARRIAK/HCSR04-EUSK-SERVO2.FCStd

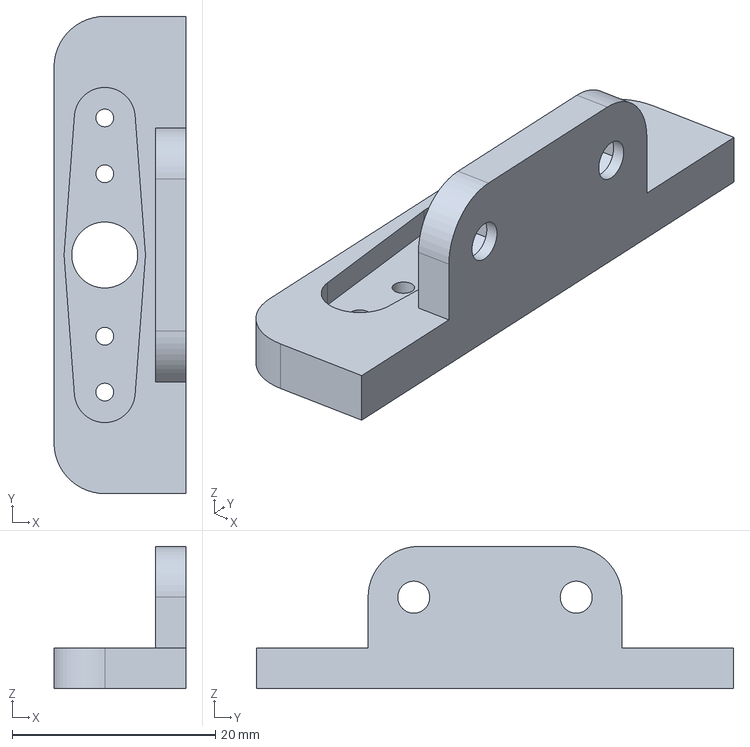
[picture p52: CAD file, 2025-07-08]
TXASIS ETA EUSKARRIAK/HCSR04-EUSK-SERVO2.FCStd
13.0 x 47.0 x 14.0 mm
