teknoroman/BotKar-UPA/MUNTAIA(api7)/MUNTAIRAKO PIEZAK/STEP/WS2812B-Ring-08LED-Black.step

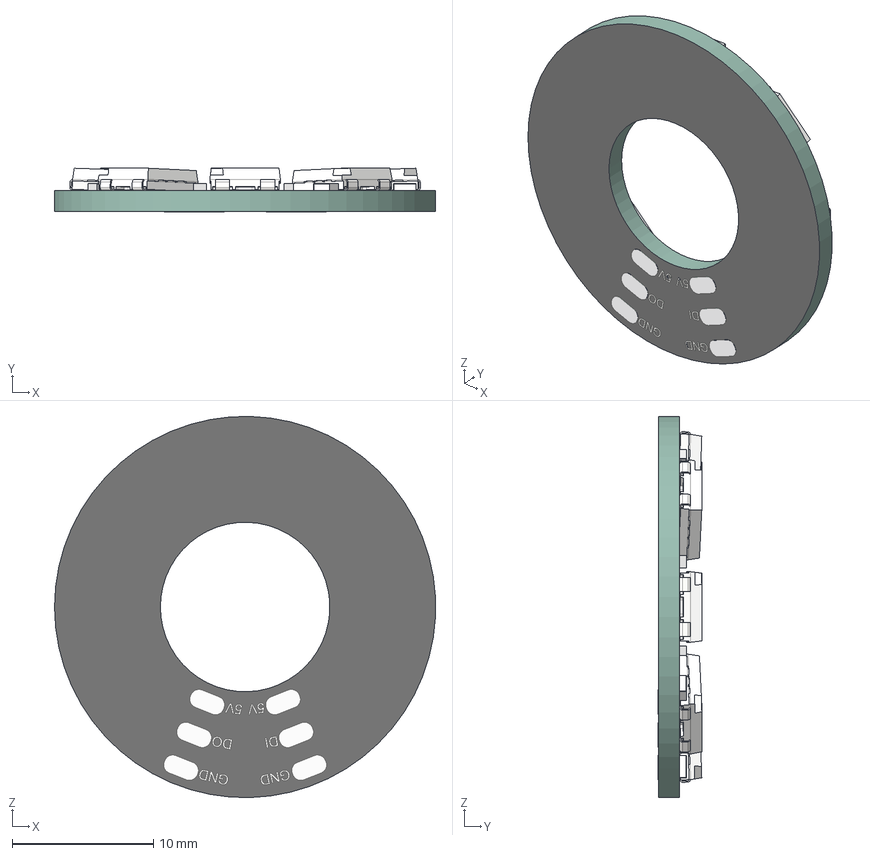
[picture p53: CAD file, 2025-07-08]
MUNTAIA(api7)/MUNTAIRAKO PIEZAK/STEP/WS2812B-Ring-08LED-Black.step
27.0 x 3.09 x 27.0 mm
WS2812B x 8
0603 Resistor x 8
