teknoroman/BotKar-UPA/MUNTAIA(api7)/TXASIS ETA EUSKARRIAK/PARACHOQUES5-Fillet001.3mf

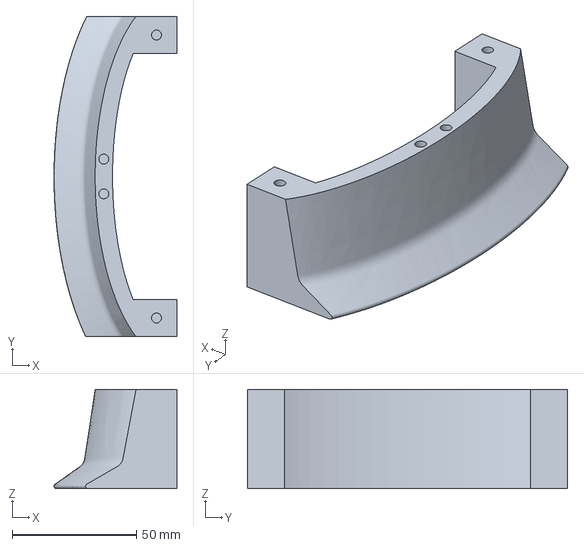
[picture p54: CAD file, 2025-07-08]
MUNTAIA(api7)/TXASIS ETA EUSKARRIAK/PARACHOQUES5-Fillet001.3mf
49.6 x 129.0 x 40.0 mm
