teknoroman/BotKar-UPA/MUNTAIRAKO PIEZAK/motEusBertikala(motorrakin)V2.FCStd

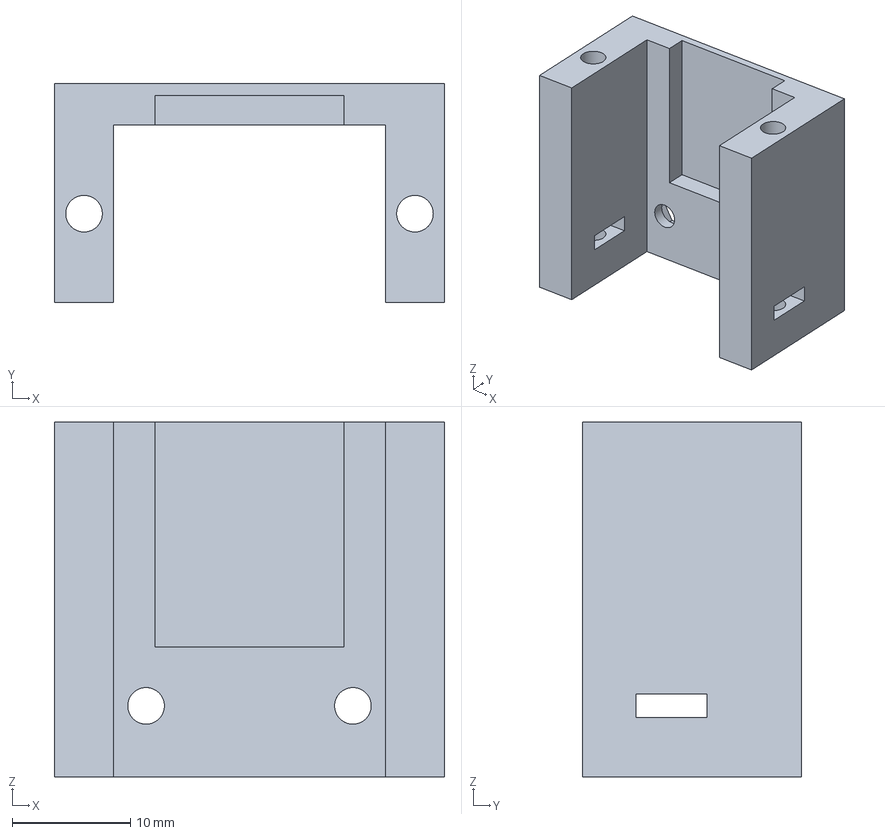
[picture p55: CAD file, 2025-07-08]
MUNTAIRAKO PIEZAK/motEusBertikala(motorrakin)V2.FCStd
33.0 x 18.5 x 30.0 mm
