teknoroman/BotKar-UPA/MUNTAIRAKO PIEZAK/STEP/SG90_arm_v2.step

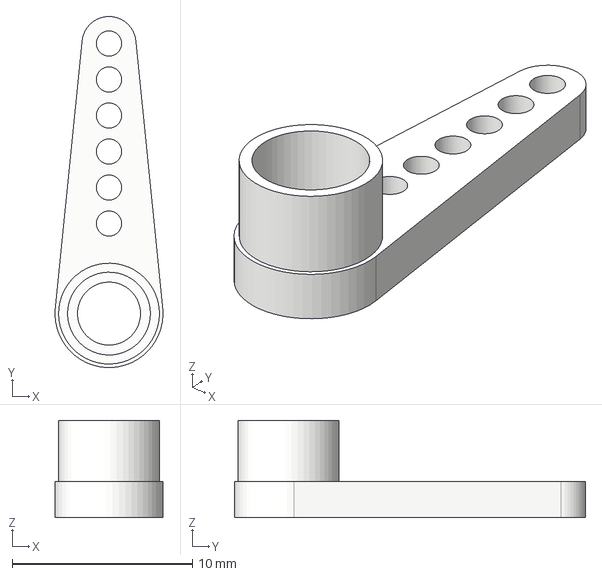
[picture p56: CAD file, 2025-07-08]
MUNTAIRAKO PIEZAK/STEP/SG90_arm_v2.step
6.00 x 19.5 x 5.40 mm
