teknoroman/BotKar-UPA/MUNTAIA(api7)/MUNTAIRAKO PIEZAK/FUNDUMOTO.FCStd

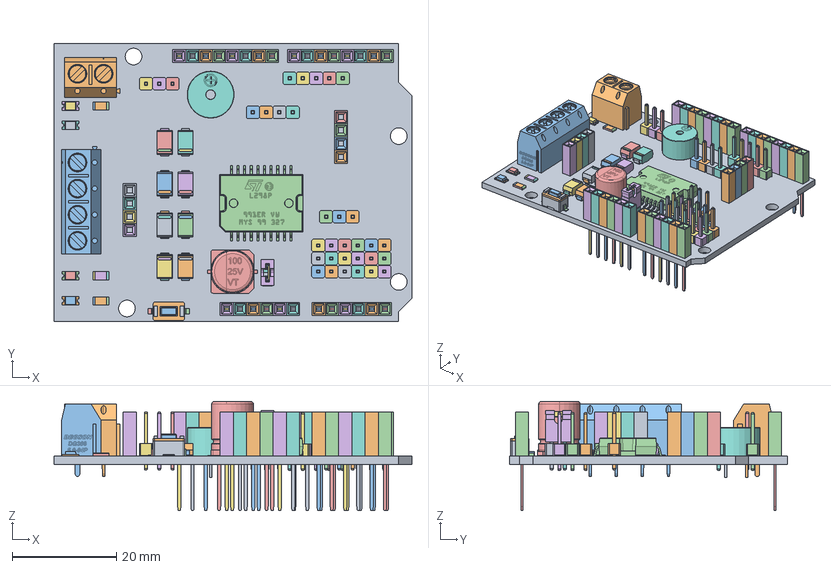
[picture p57: CAD file, 2025-07-08]
MUNTAIA(api7)/MUNTAIRAKO PIEZAK/FUNDUMOTO.FCStd
68.6 x 53.3 x 21.0 mm
Cuerpo
DG306-5.0-02P-12-00AH
DG306-5.0-04P-12-00AH
Document
Document001
Document002
Document003
Document004
Document005
Document006
Document007
Document008
Document009
Document010
Document011
Document012
Document013
Document014
Document015
Document016
Document017
Document018
Document019
Document020
Document021
Document022
Document023
L298P_Final001
100uF 25V
SIL_Socket_Body
SIL_SocketPin
SIL_Socket_Body001
SIL_SocketPin001
SIL_Socket_Body002
SIL_SocketPin002
SIL_Socket_Body003
SIL_SocketPin003
SIL_Socket_Body004
SIL_SocketPin004
SIL_Socket_Body005
SIL_SocketPin005
SIL_Socket_Body006
SIL_SocketPin006
SIL_Socket_Body007
SIL_SocketPin007
SIL_Socket_Body008
SIL_SocketPin008
SIL_Socket_Body009
SIL_SocketPin009
SIL_Socket_Body010
SIL_SocketPin010
SIL_Socket_Body011
SIL_SocketPin011
SIL_Socket_Body014
SIL_Socket_Body015
SIL_Socket_Body016
SIL_Socket_Body017
SIL_Socket_Body018
SIL_Socket_Body019
SIL_Socket_Body020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
