teknoroman/BotKar-UPA/MUNTAIA(api7)/TXASIS ETA EUSKARRIAK/3IR-euskarria2.FCStd

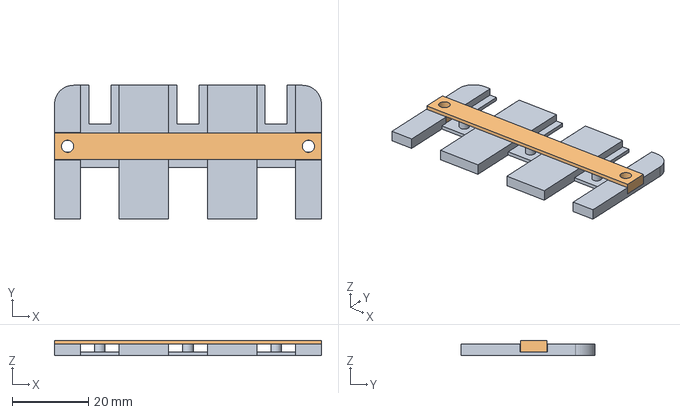
[picture p58: CAD file, 2025-07-08]
MUNTAIA(api7)/TXASIS ETA EUSKARRIAK/3IR-euskarria2.FCStd
70.0 x 35.0 x 4.00 mm
IR-EUSKARRIA_001
topea_001
