teknoroman/BotKar-UPA/MUNTAIRAKO PIEZAK/2neopixel-WS2812.FCStd

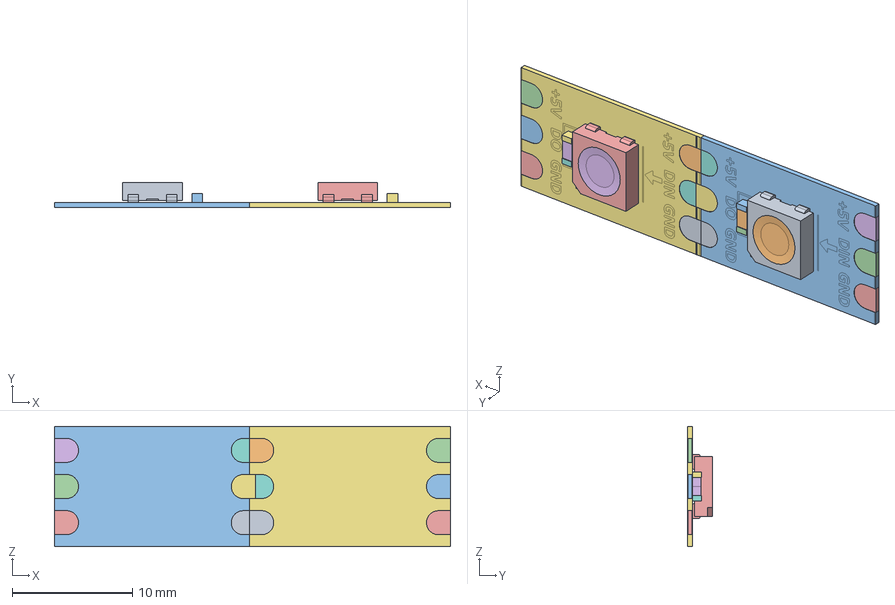
[picture p59: CAD file, 2025-07-08]
MUNTAIRAKO PIEZAK/2neopixel-WS2812.FCStd
32.9 x 2.05 x 10.0 mm
WS2812_RGB_LED_updated v3
WS2812_RGB_LED_updated v004
WS2812_RGB_LED_updated v006
WS2812_RGB_LED_updated v007
