teknoroman/BotKar-UPA/TXASIS ETA EUSKARRIAK/Ruedaloca_euskarria.FCStd

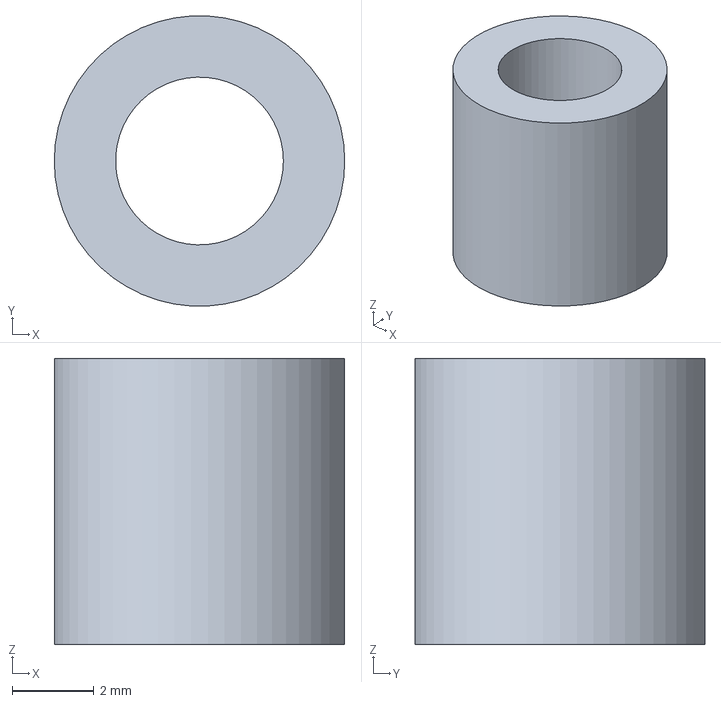
[picture p60: CAD file, 2025-07-08]
TXASIS ETA EUSKARRIAK/Ruedaloca_euskarria.FCStd
7.10 x 7.09 x 7.00 mm
