teknoroman/BotKar-UPA/MUNTAIA(api7)/MUNTAIRAKO PIEZAK/SG90-SERVO(2).FCStd

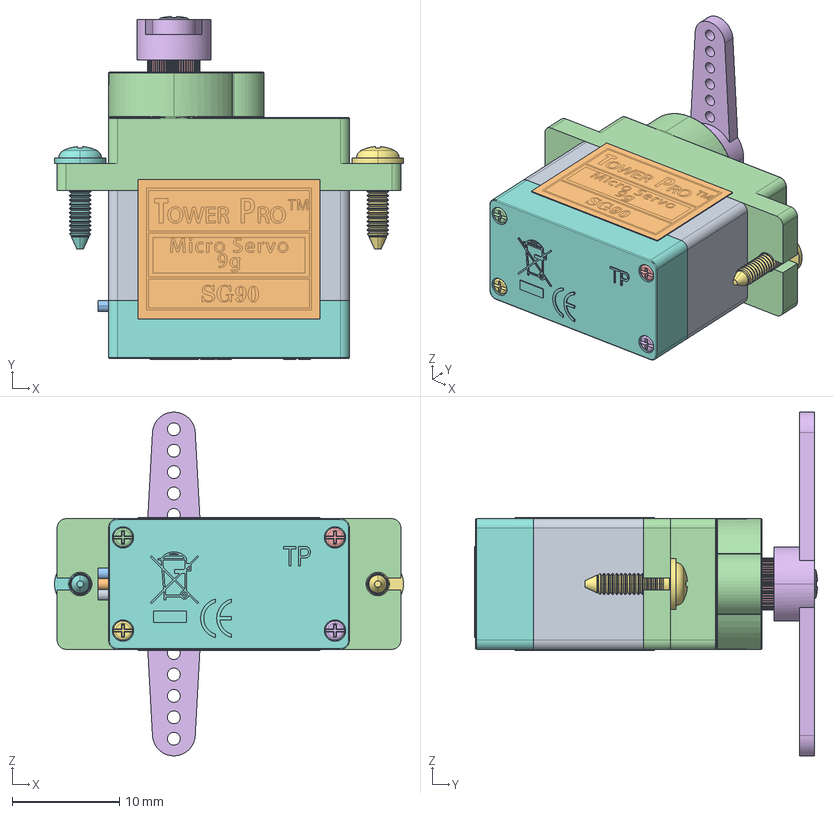
[picture p61: CAD file, 2025-07-08]
MUNTAIA(api7)/MUNTAIRAKO PIEZAK/SG90-SERVO(2).FCStd
32.6 x 32.0 x 32.1 mm
SG90 - Micro Servo 9g - Tower Pro.1_Pea
SG90 - Micro Servo 9g - Tower Pro.1_Pea001
SG90 - Micro Servo 9g - Tower Pro.1_Pea002
SG90 - Micro Servo 9g - Tower Pro.1_Pea003
SG90 - Micro Servo 9g - Tower Pro.1_Pea004
SG90 - Micro Servo 9g - Tower Pro.1_Pea005
SG90 - Micro Servo 9g - Tower Pro.1_Pea006
SG90 - Micro Servo 9g - Tower Pro.1_Pea007
SG90 - Micro Servo 9g - Tower Pro.1_Pea008
SG90 - Micro Servo 9g - Tower Pro.1_Pea009
SG90 - Micro Servo 9g - Tower Pro.1_Pea010
SG90 - Micro Servo 9g - Tower Pro.1_Pea011
SG90 - Micro Servo 9g - Tower Pro.1_Pea012
SG90 - Micro Servo 9g - Tower Pro.3_Pea
SG90 - Micro Servo 9g - Tower Pro.5_BS EN ISO 7045 - M2 x 8 - Z - 8S
SG90 - Micro Servo 9g - Tower Pro.5_BS EN ISO 7045 - M2 x 8 - Z - 8S001
SG90 - Micro Servo 9g - Tower Pro.6_BS EN ISO 7045 - M2 x 4 - Z - 4S
