teknoroman/BotKar-UPA/MUNTAIA(api7)/TXASIS ETA EUSKARRIAK/serboEuskarriak-Aurrekoa.stl

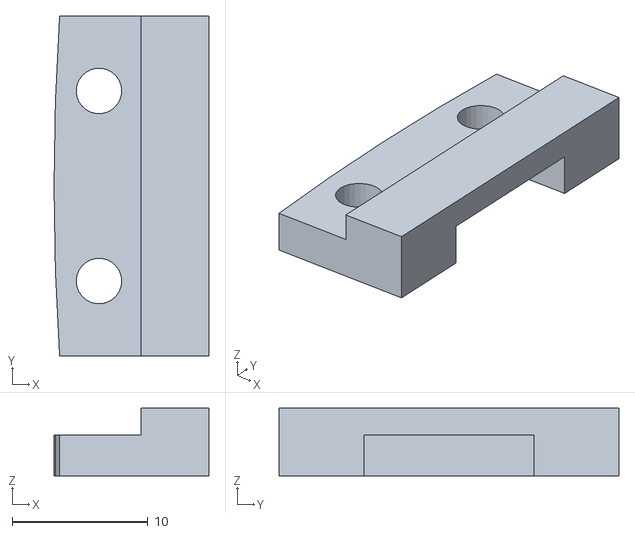
[picture p62: CAD file, 2025-07-08]
MUNTAIA(api7)/TXASIS ETA EUSKARRIAK/serboEuskarriak-Aurrekoa.stl
11.4 x 25.0 x 5.00
