teknoroman/BotKar-UPA/TXASIS ETA EUSKARRIAK/RobotChasis-UNOver8.dxf

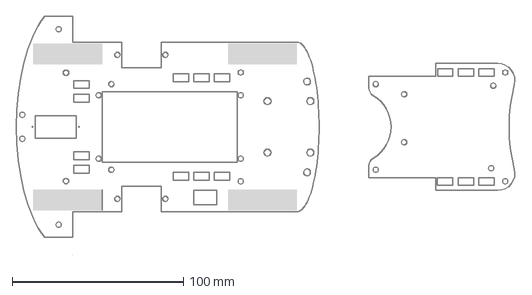
[picture p63: CAD file, 2025-07-08]
TXASIS ETA EUSKARRIAK/RobotChasis-UNOver8.dxf
291.4 x 139.0 mm
