teknoroman/BotKar-UPA/MUNTAIA(api7)/MUNTAIRAKO PIEZAK/3neopixel-WS2812.FCStd

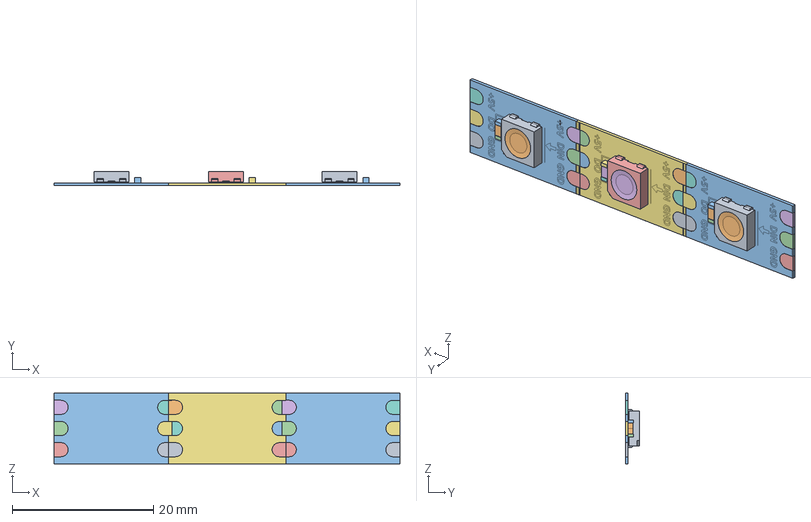
[picture p64: CAD file, 2025-07-08]
MUNTAIA(api7)/MUNTAIRAKO PIEZAK/3neopixel-WS2812.FCStd
49.0 x 2.05 x 10.0 mm
WS2812_RGB_LED_updated v3
WS2812_RGB_LED_updated v004
WS2812_RGB_LED_updated v006
WS2812_RGB_LED_updated v007
WS2812_RGB_LED_updated v009
WS2812_RGB_LED_updated v010
