teknoroman/BotKar-UPA/MUNTAIA(api7)/MUNTAIRAKO PIEZAK/mClon-soporte-ultrasonidos-simétrico-v2.FCStd

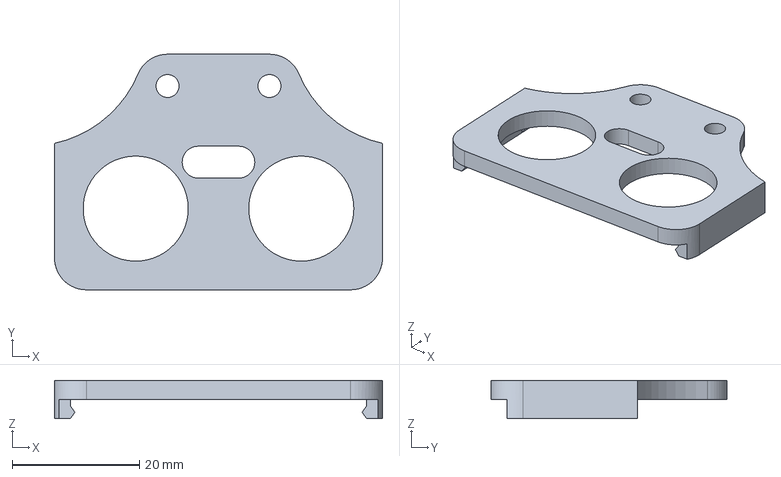
[picture p65: CAD file, 2025-07-08]
MUNTAIA(api7)/MUNTAIRAKO PIEZAK/mClon-soporte-ultrasonidos-simétrico-v2.FCStd
51.5 x 37.0 x 6.00 mm
