teknoroman/BotKar-UPA/MUNTAIRAKO PIEZAK/Arduino UNO 2.FCStd

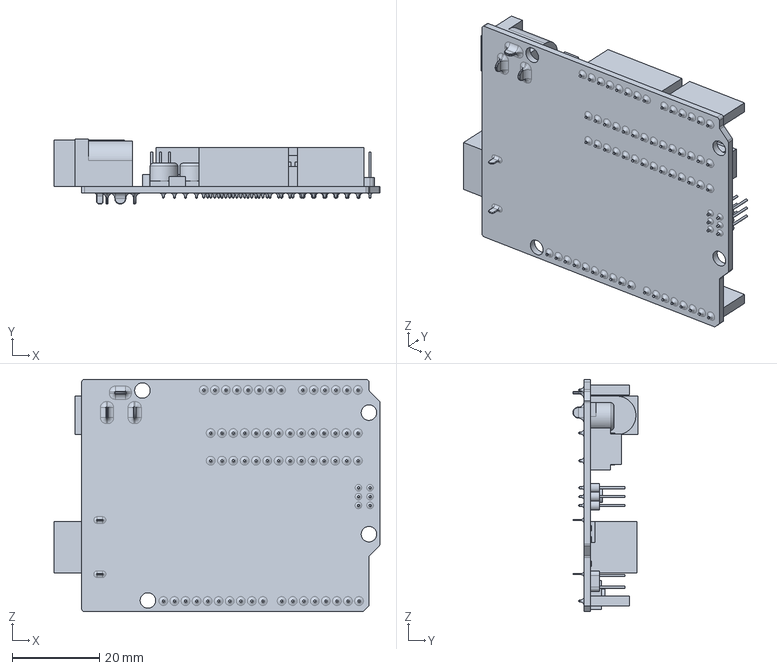
[picture p66: CAD file, 2025-07-08]
MUNTAIRAKO PIEZAK/Arduino UNO 2.FCStd
74.9 x 15.0 x 53.3 mm
