teknoroman/BotKar-UPA/TXASIS ETA EUSKARRIAK/LOGO-USAN.stl

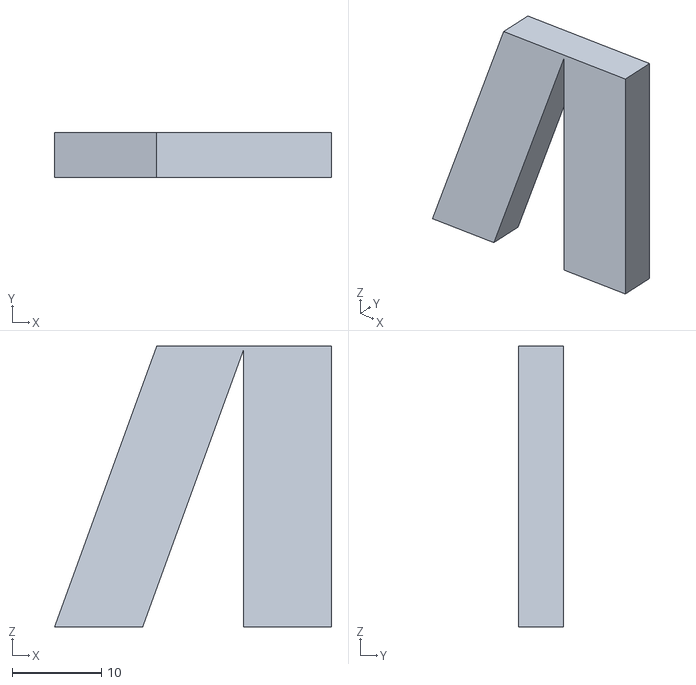
[picture p67: CAD file, 2025-07-08]
TXASIS ETA EUSKARRIAK/LOGO-USAN.stl
31.1 x 5.00 x 31.5
