teknoroman/BotKar-UPA/MUNTAIA(api7)/TXASIS ETA EUSKARRIAK/NEOPIXEL EUSKARRIA.FCStd

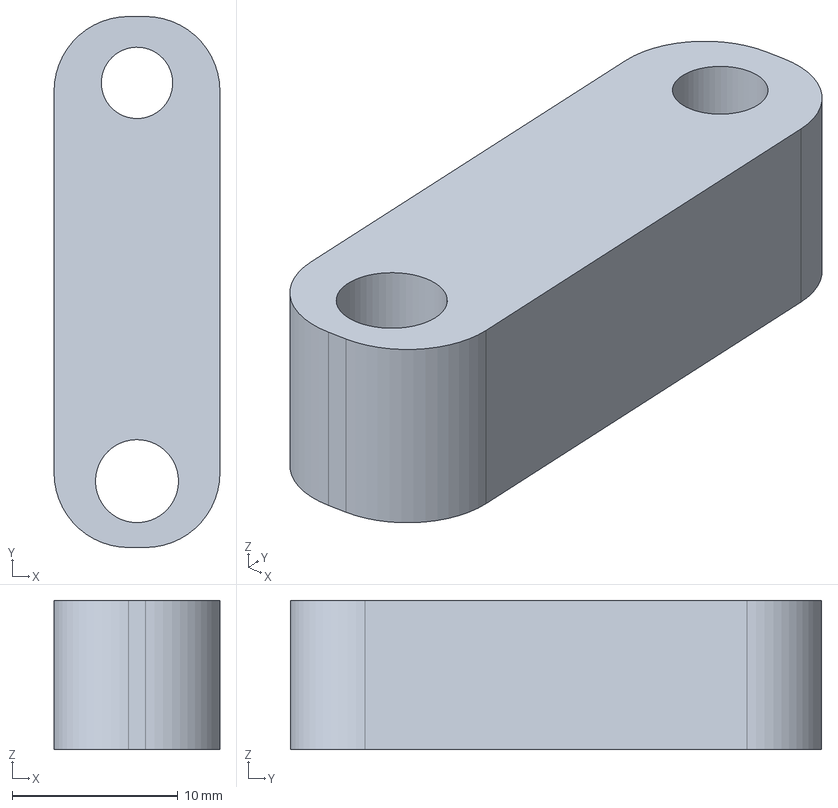
[picture p68: CAD file, 2025-07-08]
MUNTAIA(api7)/TXASIS ETA EUSKARRIAK/NEOPIXEL EUSKARRIA.FCStd
10.0 x 32.0 x 9.00 mm
