teknoroman/BotKar-UPA/TXASIS ETA EUSKARRIAK/chasisa(v.8).FCStd

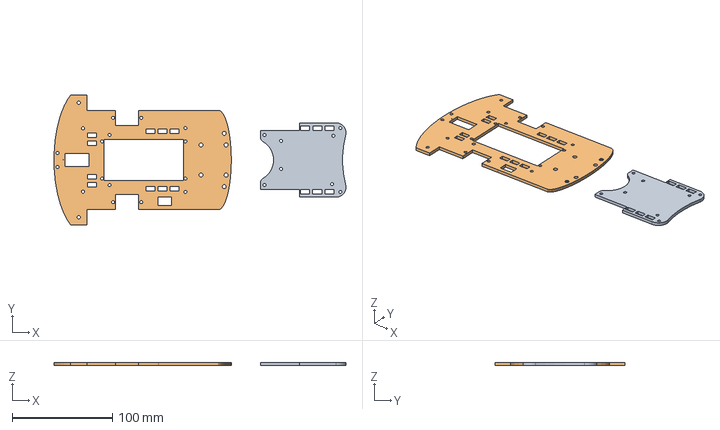
[picture p69: CAD file, 2025-07-08]
TXASIS ETA EUSKARRIAK/chasisa(v.8).FCStd
290.8 x 129.0 x 3.00 mm
UNO oinarria
txasisa
