teknoroman/BotKar-UPA/MUNTAIA(api7)/TXASIS ETA EUSKARRIAK/serboEuskarriak-Atzekoa.stl

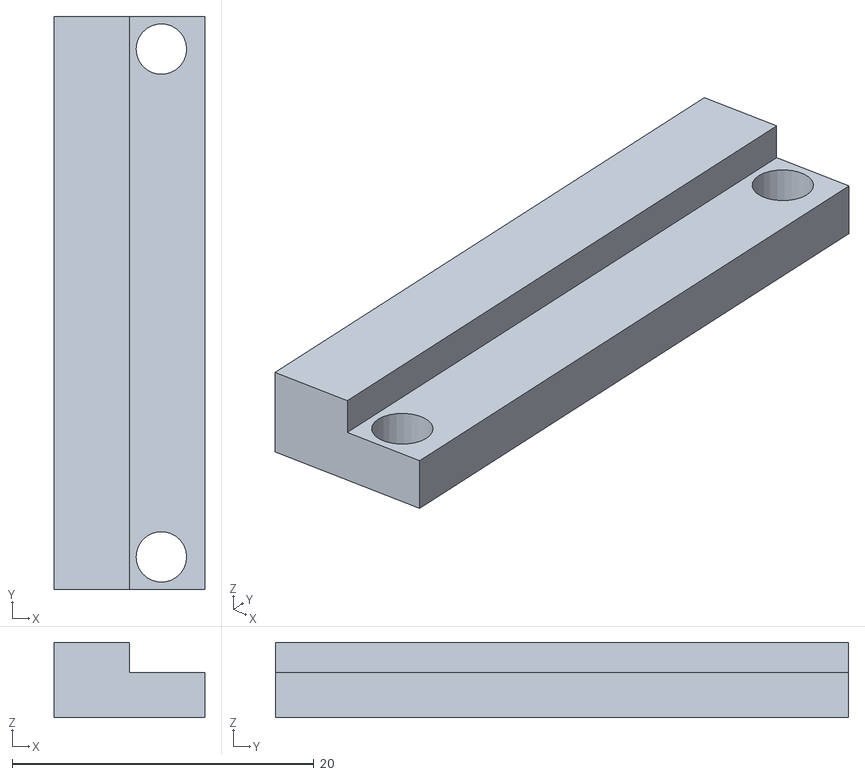
[picture p70: CAD file, 2025-07-08]
MUNTAIA(api7)/TXASIS ETA EUSKARRIAK/serboEuskarriak-Atzekoa.stl
10.0 x 38.0 x 5.00
