teknoroman/BotKar-UPA/(list of files, cad)

Other CAD files:
MUNTAIA(api7)/TXASIS ETA EUSKARRIAK/serboEuskarriak.FCStd
TXASIS ETA EUSKARRIAK/motEusBertikala(motorrakin)V2.FCStd
TXASIS ETA EUSKARRIAK/PARACHOQUES5.FCStd
MUNTAIA(api7)/TXASIS ETA EUSKARRIAK/motEusBertikala(motorrakin)V2.FCStd
MUNTAIA(api7)/TXASIS ETA EUSKARRIAK/PARACHOQUES5.FCStd
MUNTAIA(api7)/MUNTAIRAKO PIEZAK/STEP/18650 Li-Ion.step
MUNTAIA(api7)/TXASIS ETA EUSKARRIAK/PARACHOQUES5-Fillet001.stl
MUNTAIA(api7)/TXASIS ETA EUSKARRIAK/parachoques5.dxf
MUNTAIRAKO PIEZAK/STEP/18650 Li-Ion.step
TXASIS ETA EUSKARRIAK/PARACHOQUES5-Fillet001.stl
TXASIS ETA EUSKARRIAK/parachoques5.dxf
