teknoroman/BotKar-UPA/MUNTAIA (mar24)-Assembly.pdf

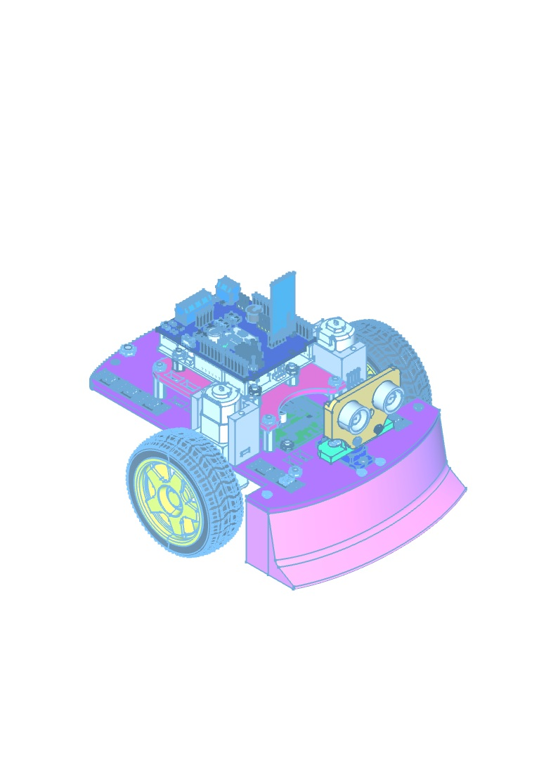
[picture p85: page 1]
