teknoroman/BotKar-UPA/PROGRAMAK/Distantzia neurtzeko testa.png

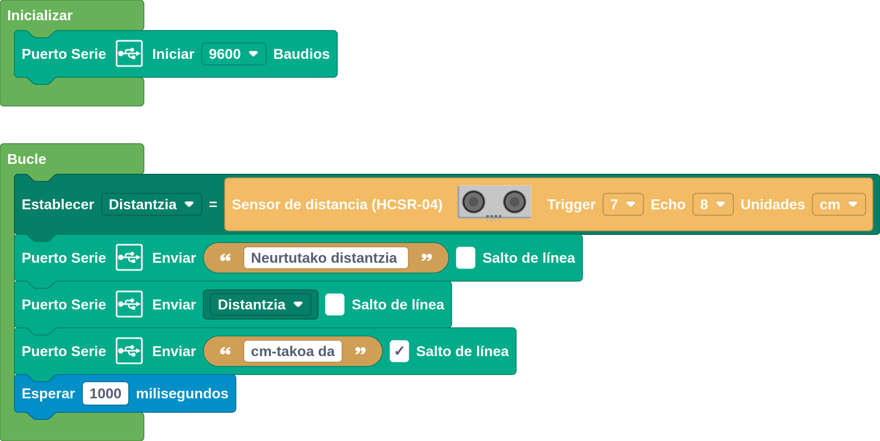
PROGRAMAK/Distantzia neurtzeko testa.png
