teknoroman/BotKar-UPA/PROGRAMAK/IR egoeraren testa.png

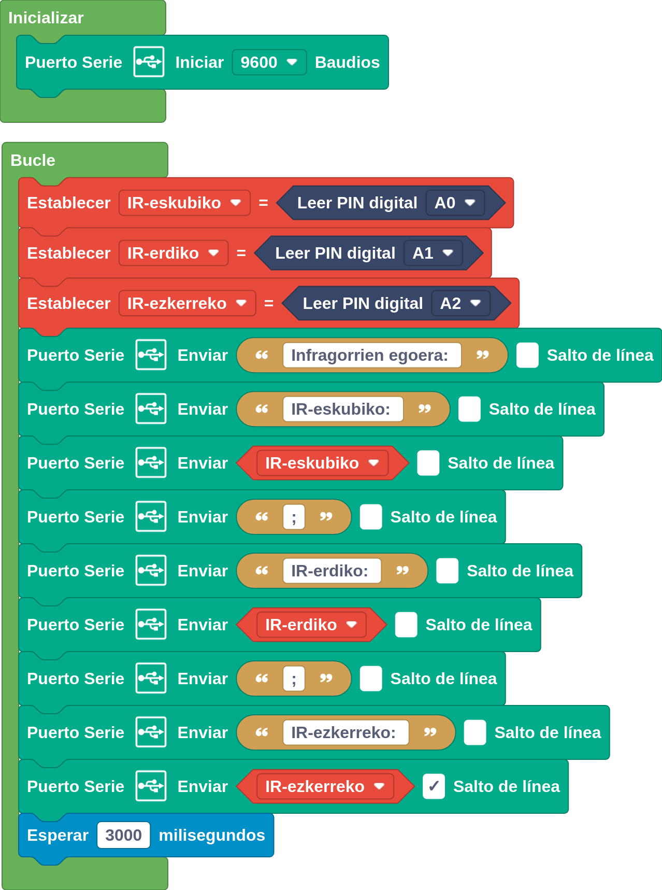
PROGRAMAK/IR egoeraren testa.png
