teknoroman/BotKar-UPA/PROGRAMAK/SOINU TESTA (BotKarUPA-HelloBlocks.png

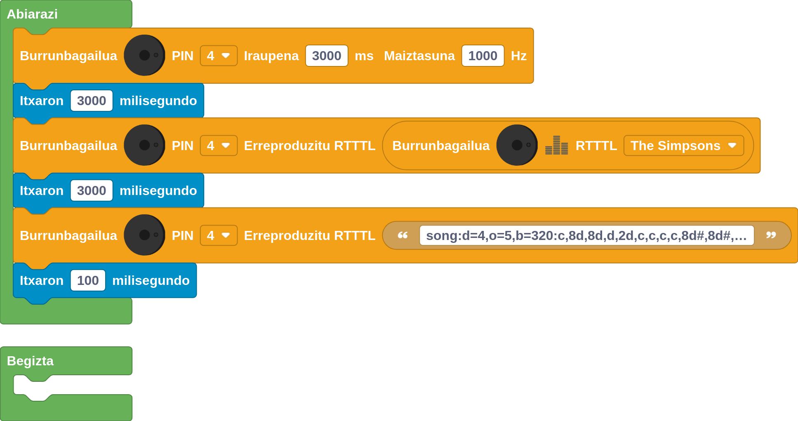
PROGRAMAK/SOINU TESTA (BotKarUPA-HelloBlocks.png
