teknoroman/BotKar-UPA/Testak/Distantzia neurtzeko testa.png

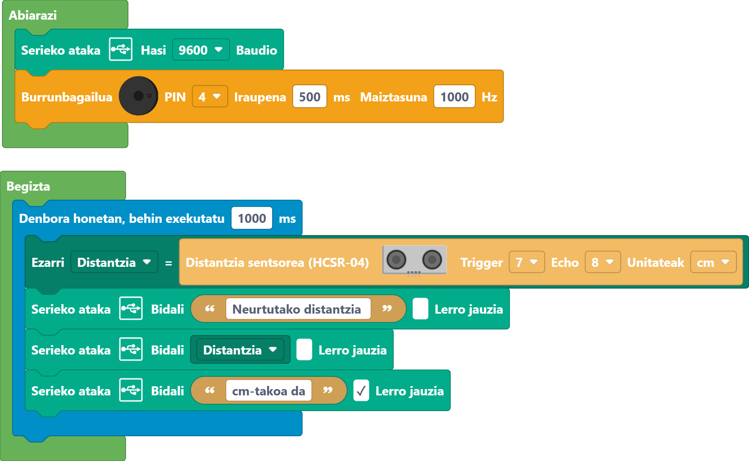
Testak/Distantzia neurtzeko testa.png
