teknoroman/BotKar-UPA/Testak/INFRAGORRIEN EGOERA - TESTA.png

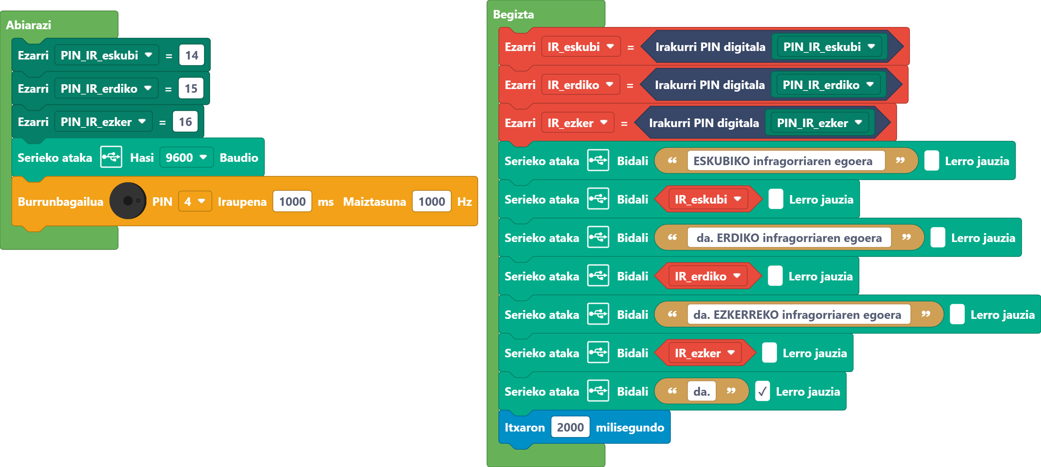
Testak/INFRAGORRIEN EGOERA - TESTA.png
