teknoroman/BotKar-UPA/Testak/ULTRASOINU-SERBO OZTOPOAK NEURTZEN.png

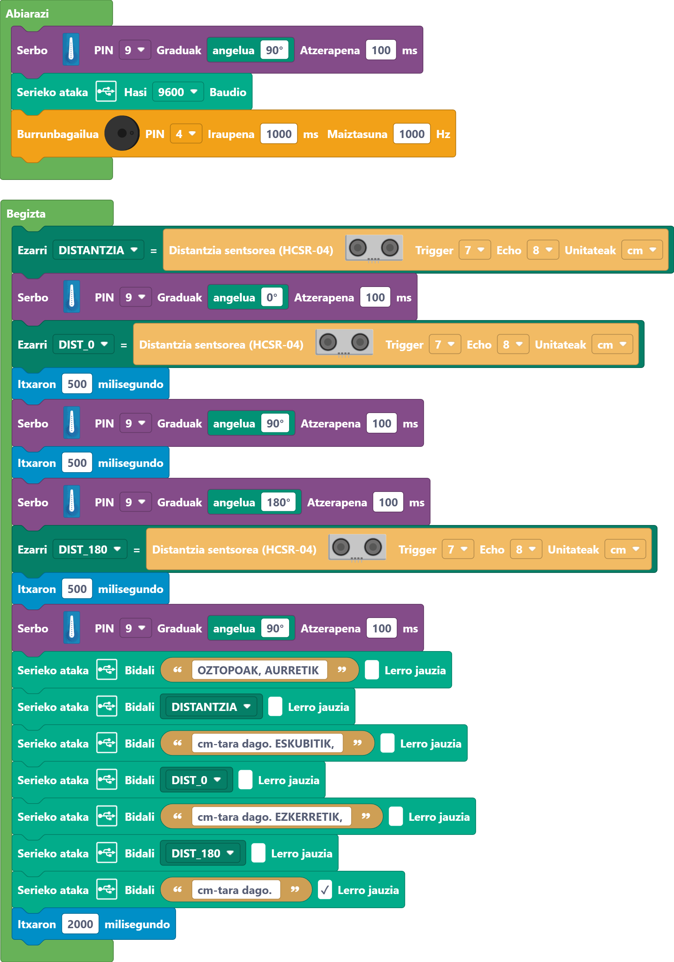
Testak/ULTRASOINU-SERBO OZTOPOAK NEURTZEN.png
