teknoroman/BotKar-UPA/(commit log)

2025-07-08 bertsio erabilgarria
    [18650 Li-Ion.step, 2neopixel-WS2812.FCStd, 3IR-euskarria2.FCStd, 3neopixel-WS2812.FCStd, Arduino UNO 2.FCStd, CasterWheel.stp, Etengailua.FCStd, FUNDUMOTO.FCStd]
2025-07-08 añadido el .gitignore
2025-07-21 Drive-n zegoena
    [BotKar-UPA - LISTADO MATERIAL.xlsx, BotKar-UPA - MATERIAL ZERRENDA.xlsx]
